philmcm/tbc/3dmodels/LQM21DH100M70L.STEP

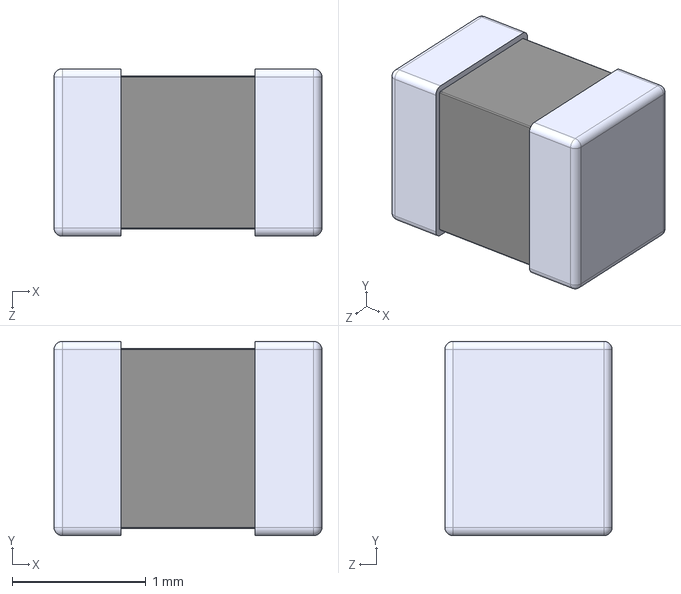
[picture p1: CAD file, 2024-02-20]
3dmodels/LQM21DH100M70L.STEP
2.00 x 1.45 x 1.25 mm
