philmcm/tbc/3dmodels/GRM32ER71E226KE15L.STEP

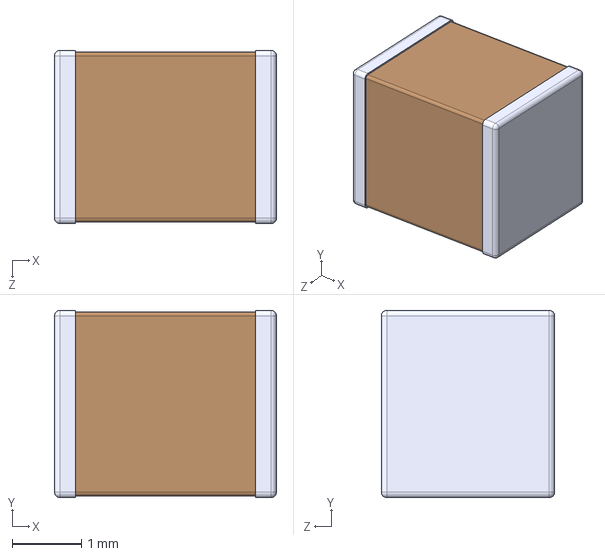
[picture p2: CAD file, 2024-02-19]
3dmodels/GRM32ER71E226KE15L.STEP
3.20 x 2.70 x 2.50 mm
