philmcm/tbc/3dmodels/ABLS.STEP

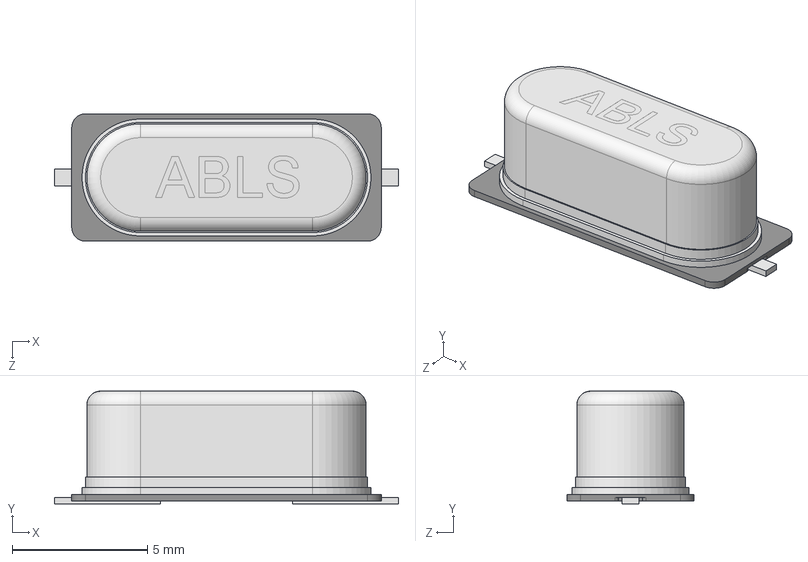
[picture p3: CAD file, 2024-02-18]
3dmodels/ABLS.STEP
12.7 x 4.17 x 4.70 mm
