philmcm/tbc/3dmodels/ABLS2.STEP

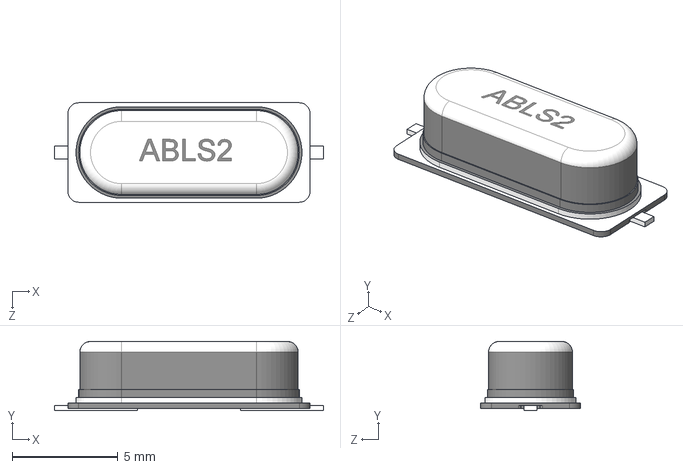
[picture p4: CAD file, 2024-02-18]
3dmodels/ABLS2.STEP
12.7 x 3.27 x 4.70 mm
