philmcm/tbc/3dmodels/D0014A.stp

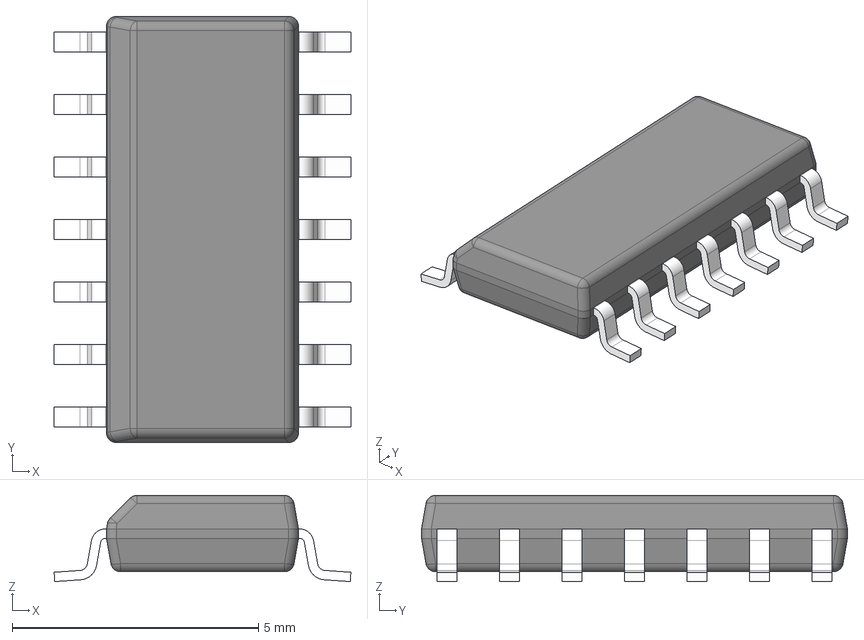
[picture p5: CAD file, 2024-02-14]
3dmodels/D0014A.stp
6.03 x 8.65 x 1.75 mm
BODY-SO
LEAD-SO x 14
PIN1-ID
