philmcm/tbc/3dmodels/ACHL.STEP

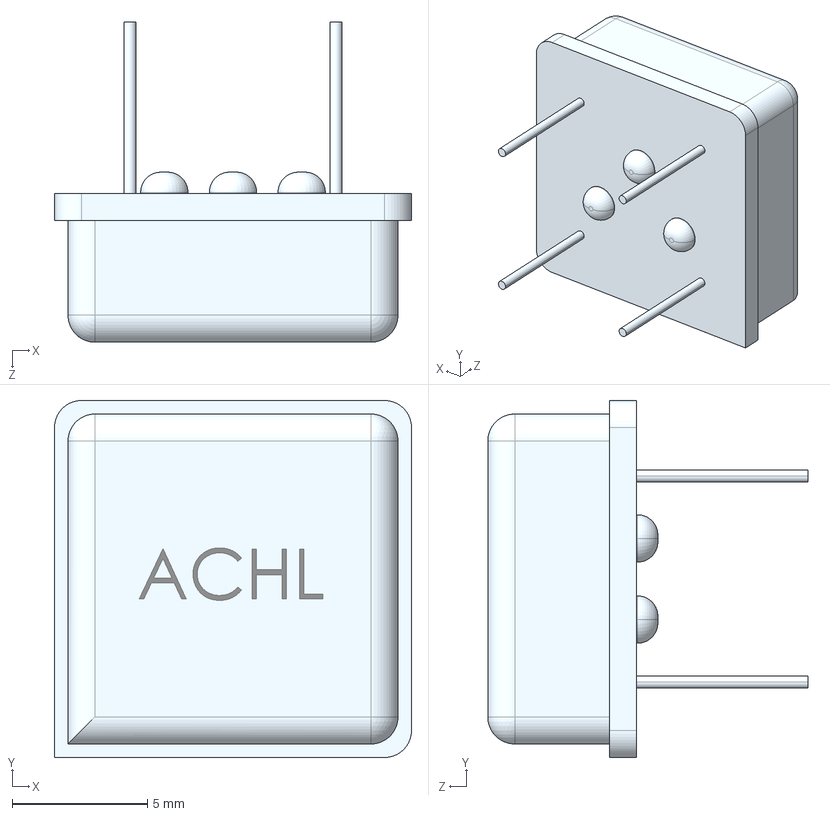
[picture p6: CAD file, 2024-02-12]
3dmodels/ACHL.STEP
13.2 x 13.2 x 11.9 mm
