philmcm/tbc/3dmodels/FSM4JLH(1825910-5).step

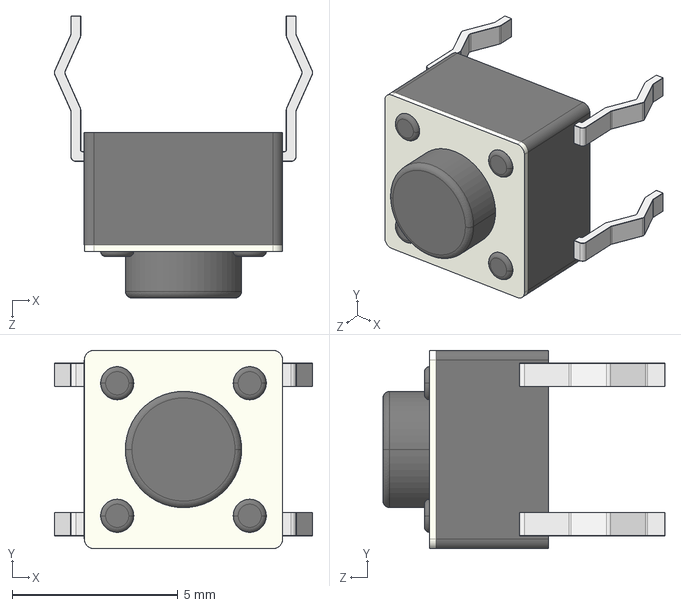
[picture p8: CAD file, 2024-02-12]
3dmodels/FSM4JLH(1825910-5).step
7.80 x 5.99 x 8.51 mm
