philmcm/tbc/3dmodels/KTT0003B.stp

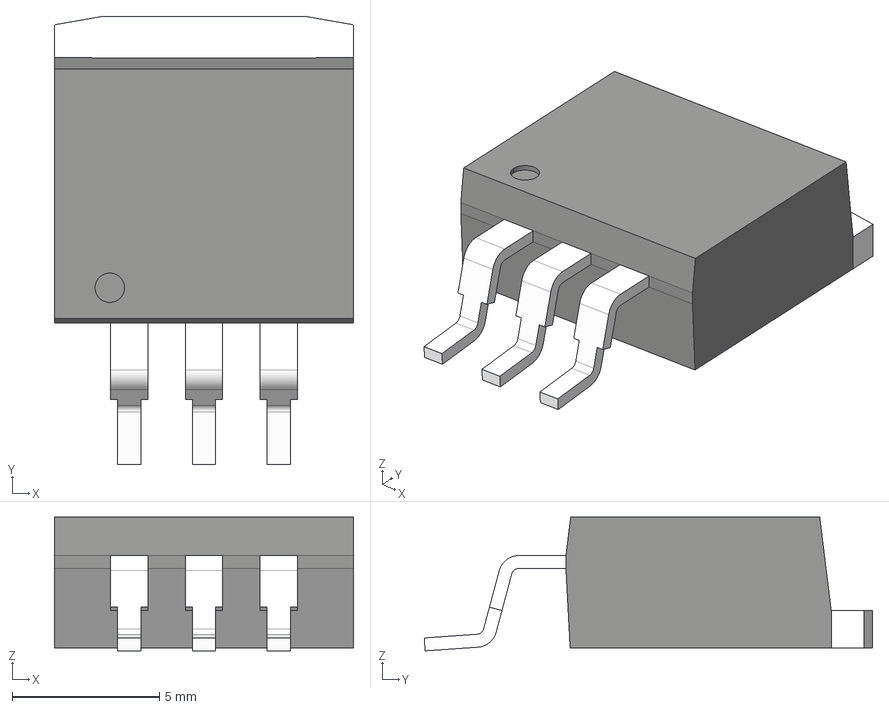
[picture p9: CAD file, 2024-02-11]
3dmodels/KTT0003B.stp
10.2 x 15.2 x 4.54 mm
BODY-TO
HTSINK-TO263
LEAD-TO263 x 3
