philmcm/tbc/3dmodels/C-CASE.stp

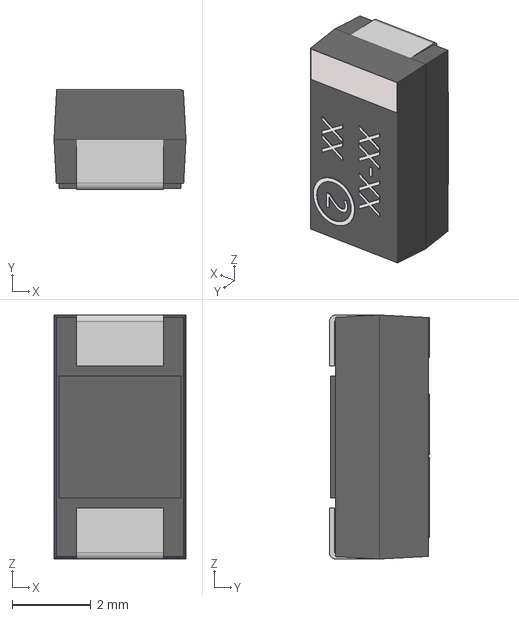
[picture p10: CAD file, 2024-02-11]
3dmodels/C-CASE.stp
3.35 x 2.54 x 6.20 mm
