philmcm/tbc/3dmodels/D-CASE.stp

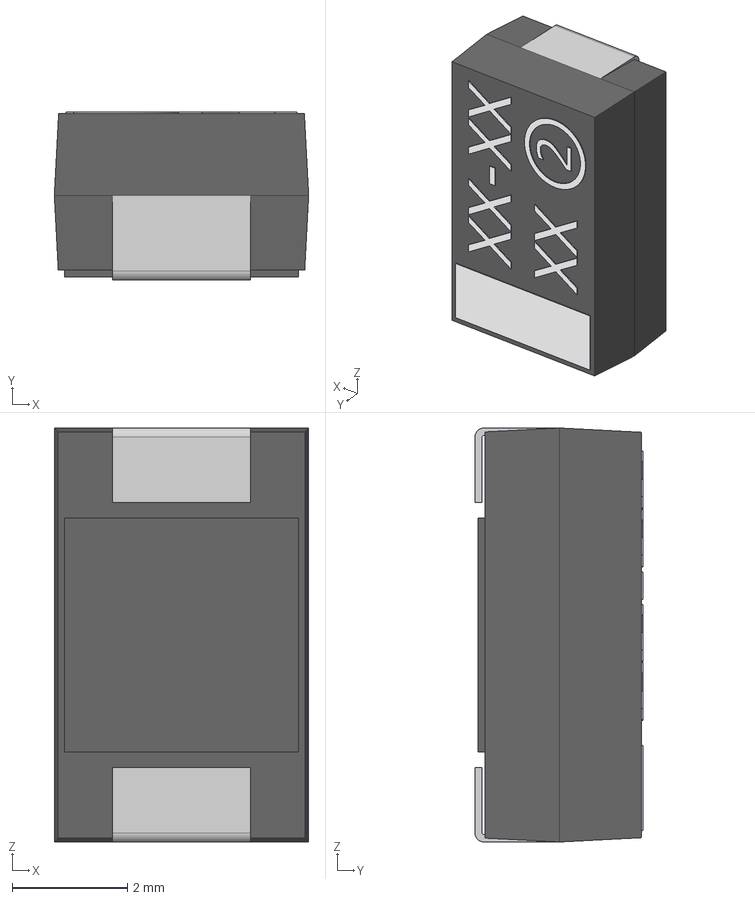
[picture p11: CAD file, 2024-02-11]
3dmodels/D-CASE.stp
4.42 x 2.92 x 7.19 mm
