philmcm/tbc/3dmodels/CircuitWorks-SOT-23.step

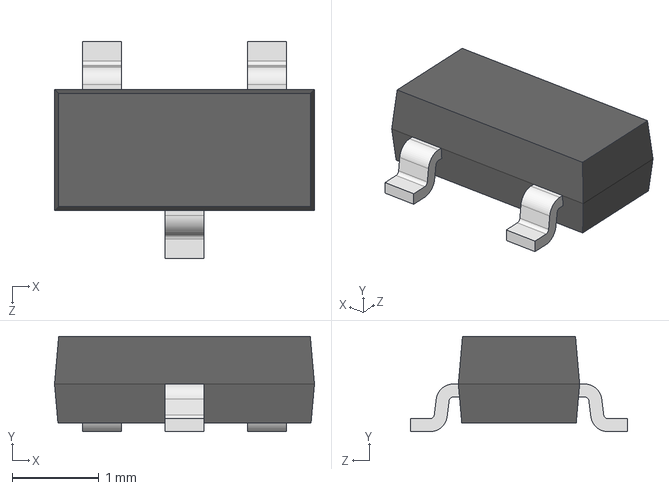
[picture p12: CAD file, 2024-02-11]
3dmodels/CircuitWorks-SOT-23.step
3.00 x 1.10 x 2.50 mm
