philmcm/tbc/3dmodels/PJRAN3X1U03X--3DModel-STEP-56544.STEP

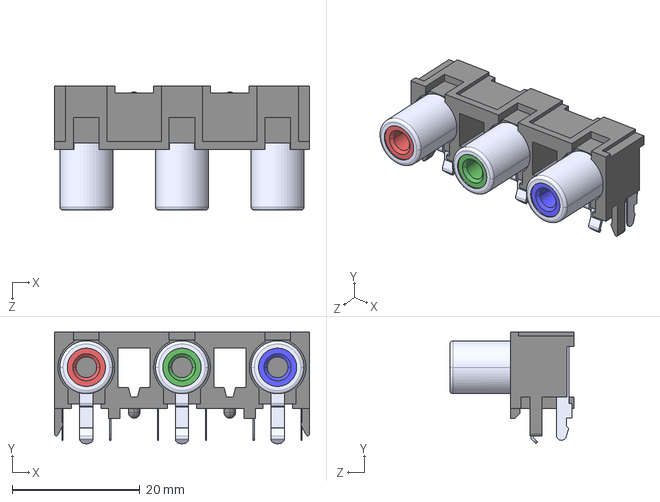
[picture p13: CAD file, 2024-02-11]
3dmodels/PJRAN3X1U03X--3DModel-STEP-56544.STEP
40.0 x 17.5 x 19.5 mm
