philmcm/tbc/3dmodels/A11AH-GA.stp

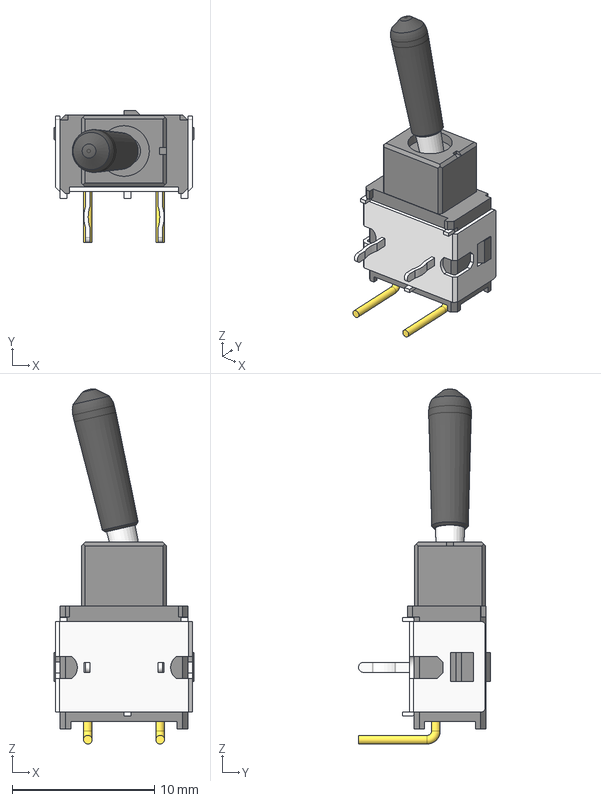
[picture p14: CAD file, 2024-02-11]
3dmodels/A11AH-GA.stp
9.80 x 9.27 x 24.9 mm
A1-toggle-body
A11H-toggle-terminals
A1H-toggle-bracket_ra
AA-toggle-toggle
AA-GA-toggle-cap
