philmcm/tbc/3dmodels/c-5749181-1-a-3d.stp

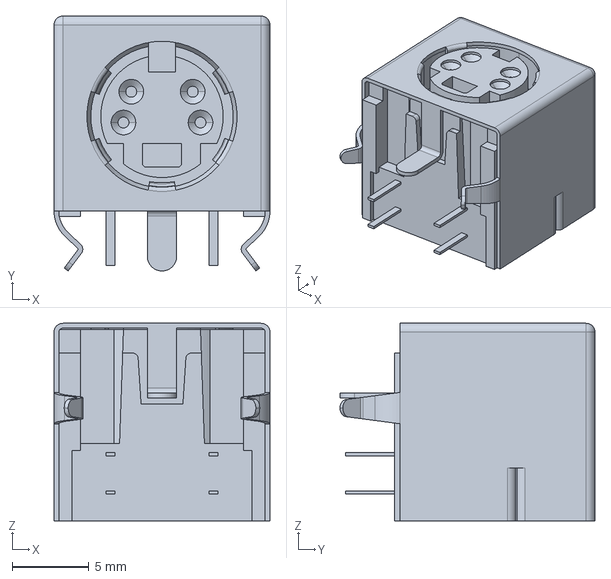
[picture p15: CAD file, 2024-02-11]
3dmodels/c-5749181-1-a-3d.stp
14.0 x 16.6 x 12.8 mm
