philmcm/tbc/3dmodels/4840.2201-04.STEP

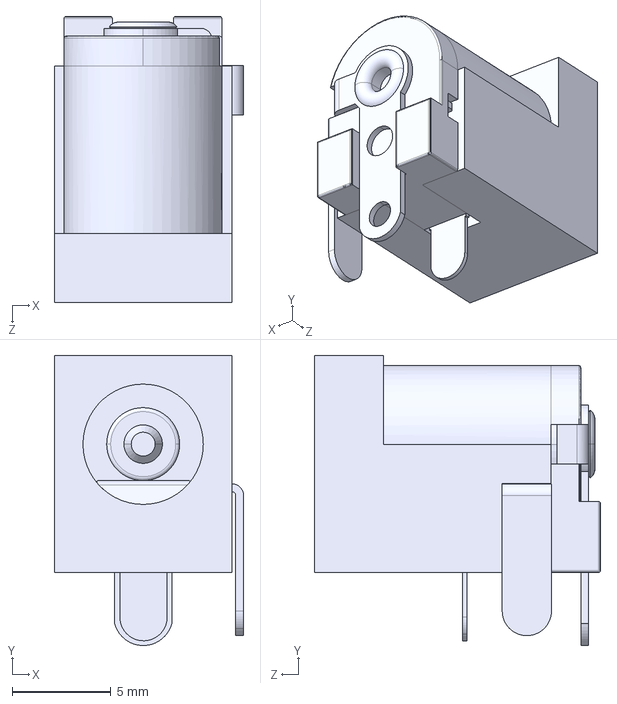
[picture p16: CAD file, 2024-02-11]
3dmodels/4840.2201-04.STEP
9.59 x 14.7 x 14.5 mm
