philmcm/tbc/3dmodels/pjran1x1_Series.STEP

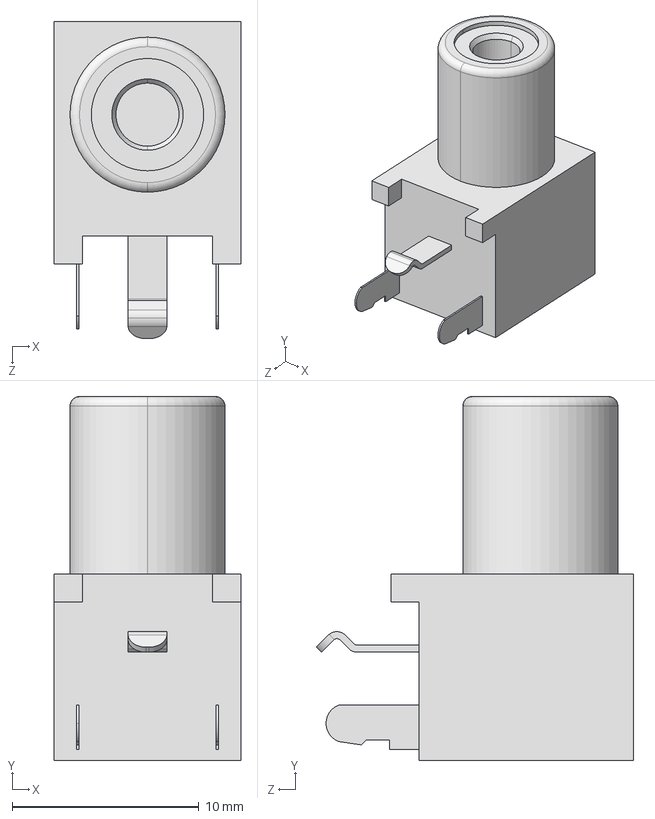
[picture p17: CAD file, 2024-02-11]
3dmodels/pjran1x1_Series.STEP
10.00 x 19.5 x 17.0 mm
