philmcm/tbc/3dmodels/R0603.step

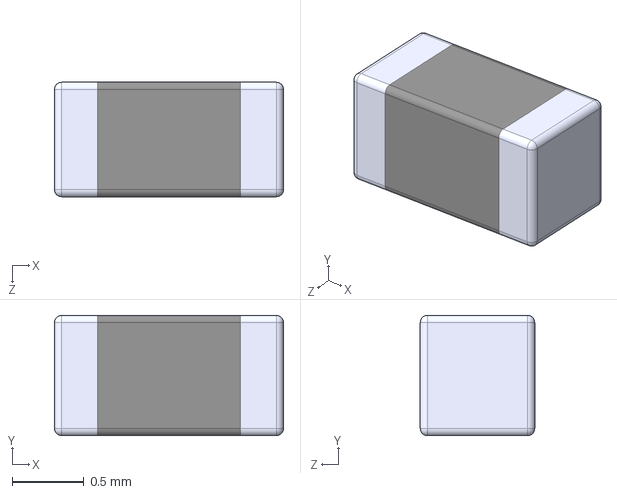
[picture p18: CAD file, 2024-02-10]
3dmodels/R0603.step
1.60 x 0.84 x 0.8 mm
