philmcm/tbc/3dmodels/QFP80_080.step

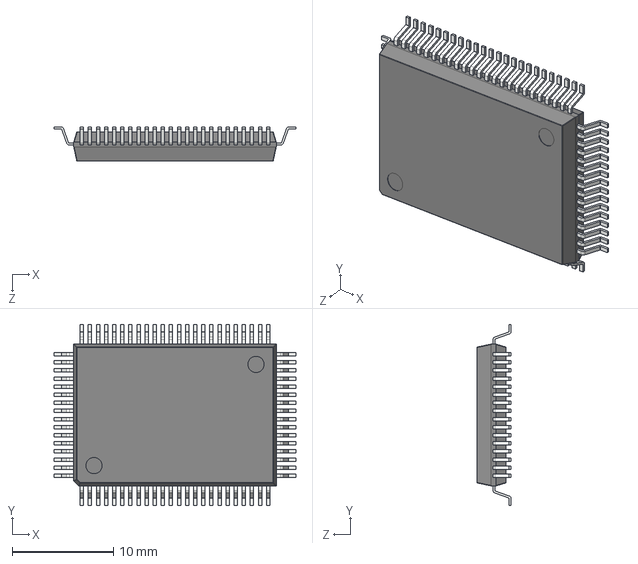
[picture p19: CAD file, 2024-02-10]
3dmodels/QFP80_080.step
23.9 x 17.9 x 3.40 mm
