philmcm/tbc/3dmodels/LQFP32.STEP

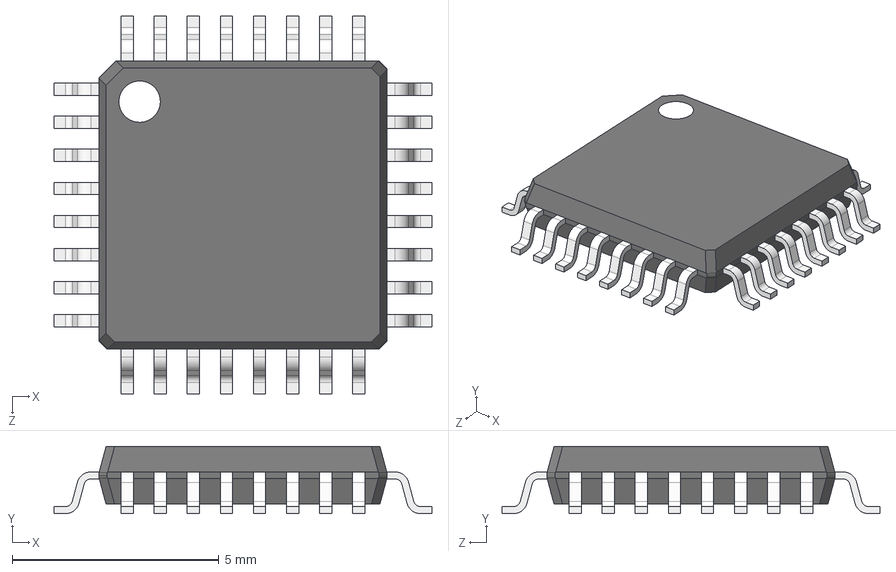
[picture p20: CAD file, 2024-02-10]
3dmodels/LQFP32.STEP
9.14 x 1.63 x 9.14 mm
case
pin x 32
circle
