philmcm/tbc/3dmodels/TSOP-44_II.step

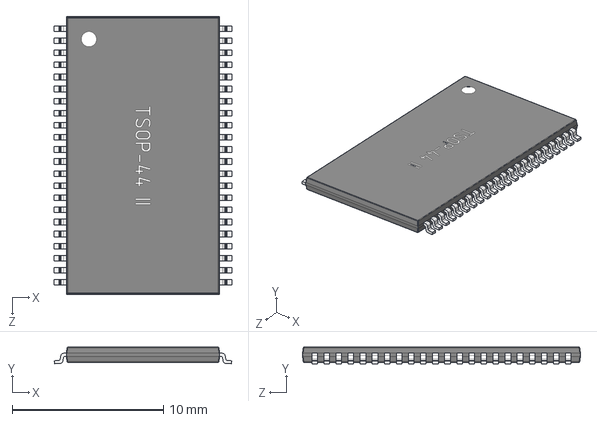
[picture p21: CAD file, 2024-02-10]
3dmodels/TSOP-44_II.step
11.8 x 1.10 x 18.4 mm
