philmcm/tbc/3dmodels/LQFP100_05.step

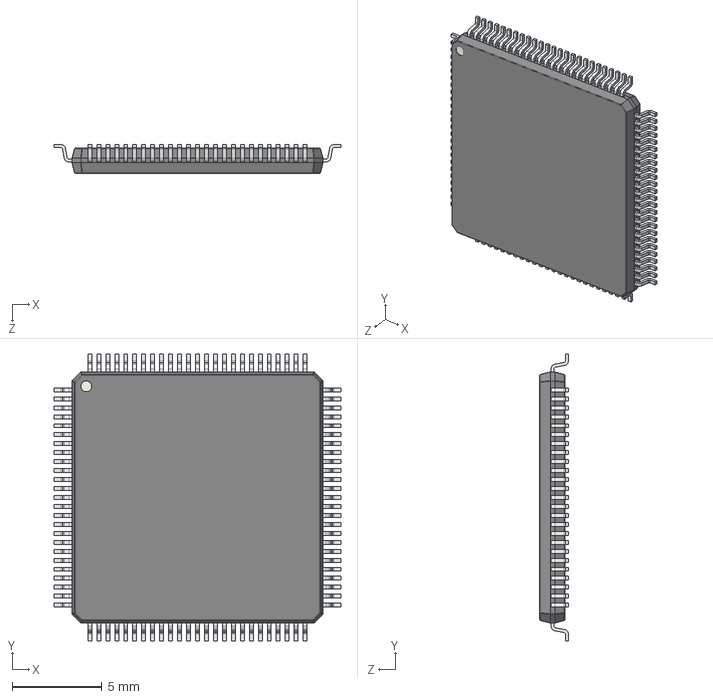
[picture p22: CAD file, 2024-01-27]
3dmodels/LQFP100_05.step
16.0 x 16.0 x 1.60 mm
