philmcm/tbc/(list of files, cad)

Other CAD files:
3dmodels/20021111-00010T4LF.STEP
3dmodels/75869-105LF--3DModel-STEP-56544.STEP
3dmodels/DFE201610E-100M%3DP2.STEP
