philmcm/tbc/plots/tbc__Assembly.pdf

1 | 2 | 3 | 4 | 5 | 6

A

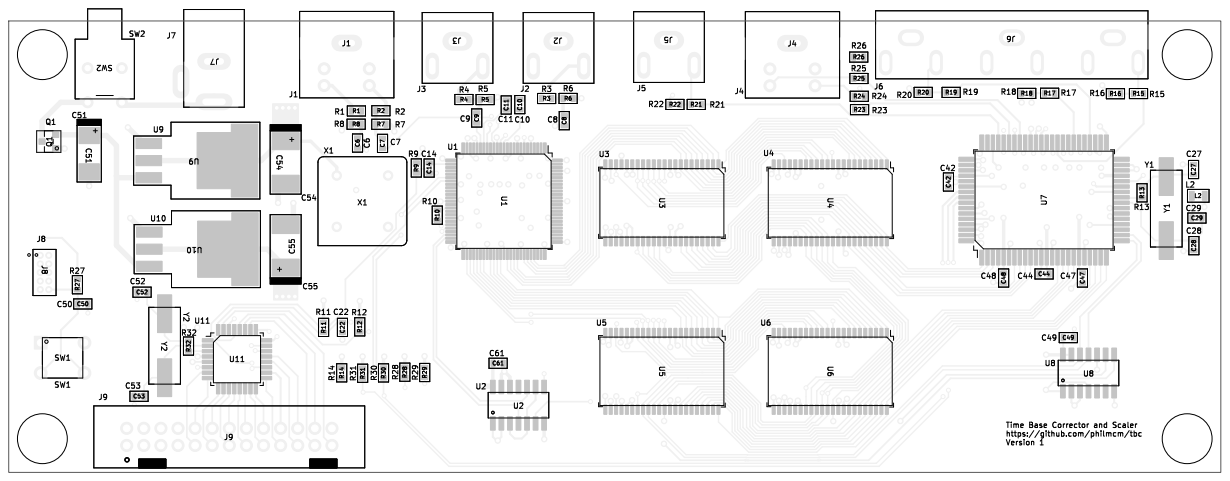
[picture p23: page 1]

Id: 1/1 Title: File: tbc.kicad_pcb Sheet: C⁹ + C⁵⁵

1 | 2 | 3 | 4 | 5 | 6

A

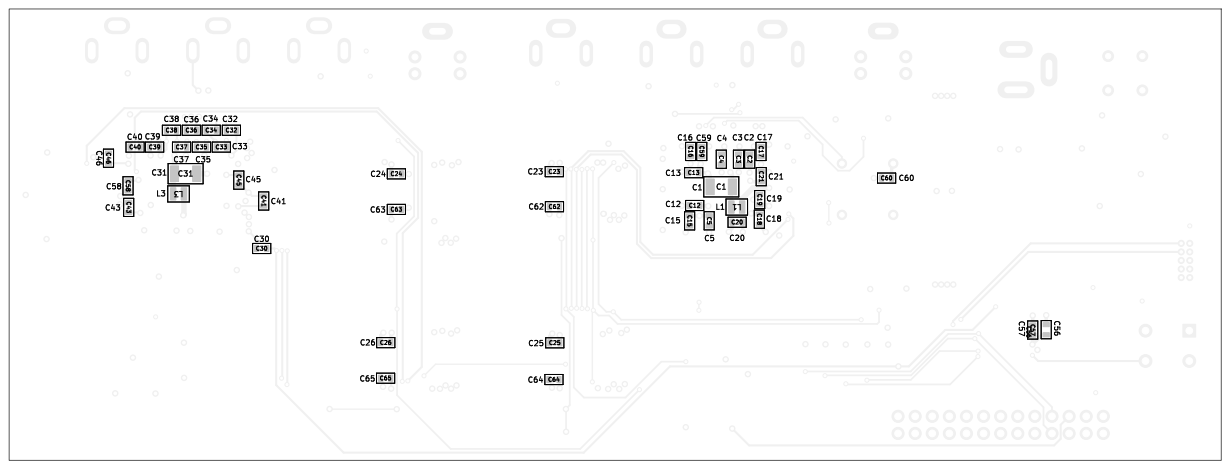
[picture p24: page 2]

Id: 1/1 Title: File: tbc.kicad_pcb Sheet:
