philmcm/tbc/tbc.pdf

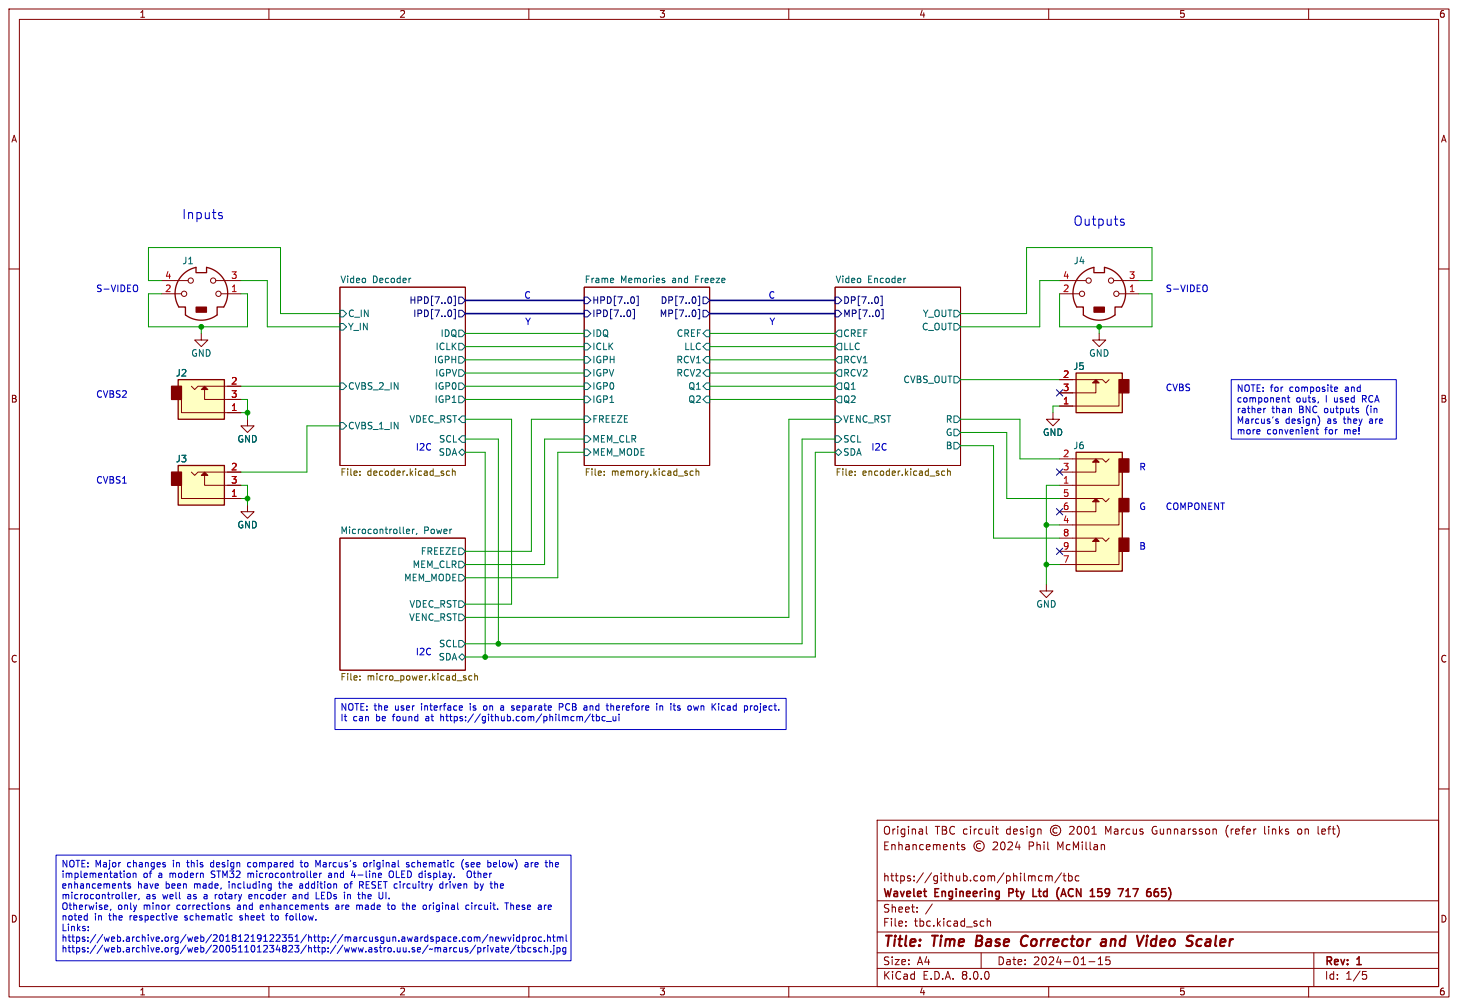
[picture p25: page 1]

C_OUT CVBS_OUT Y_OUT VENC_RST Q2 Q1 Video Encoder File: encoder.kicad_sch SDA

https://web.archive.org/web/20051101234823/http://www.astro.uu.se/~marcus/private/tbcsch.jpg

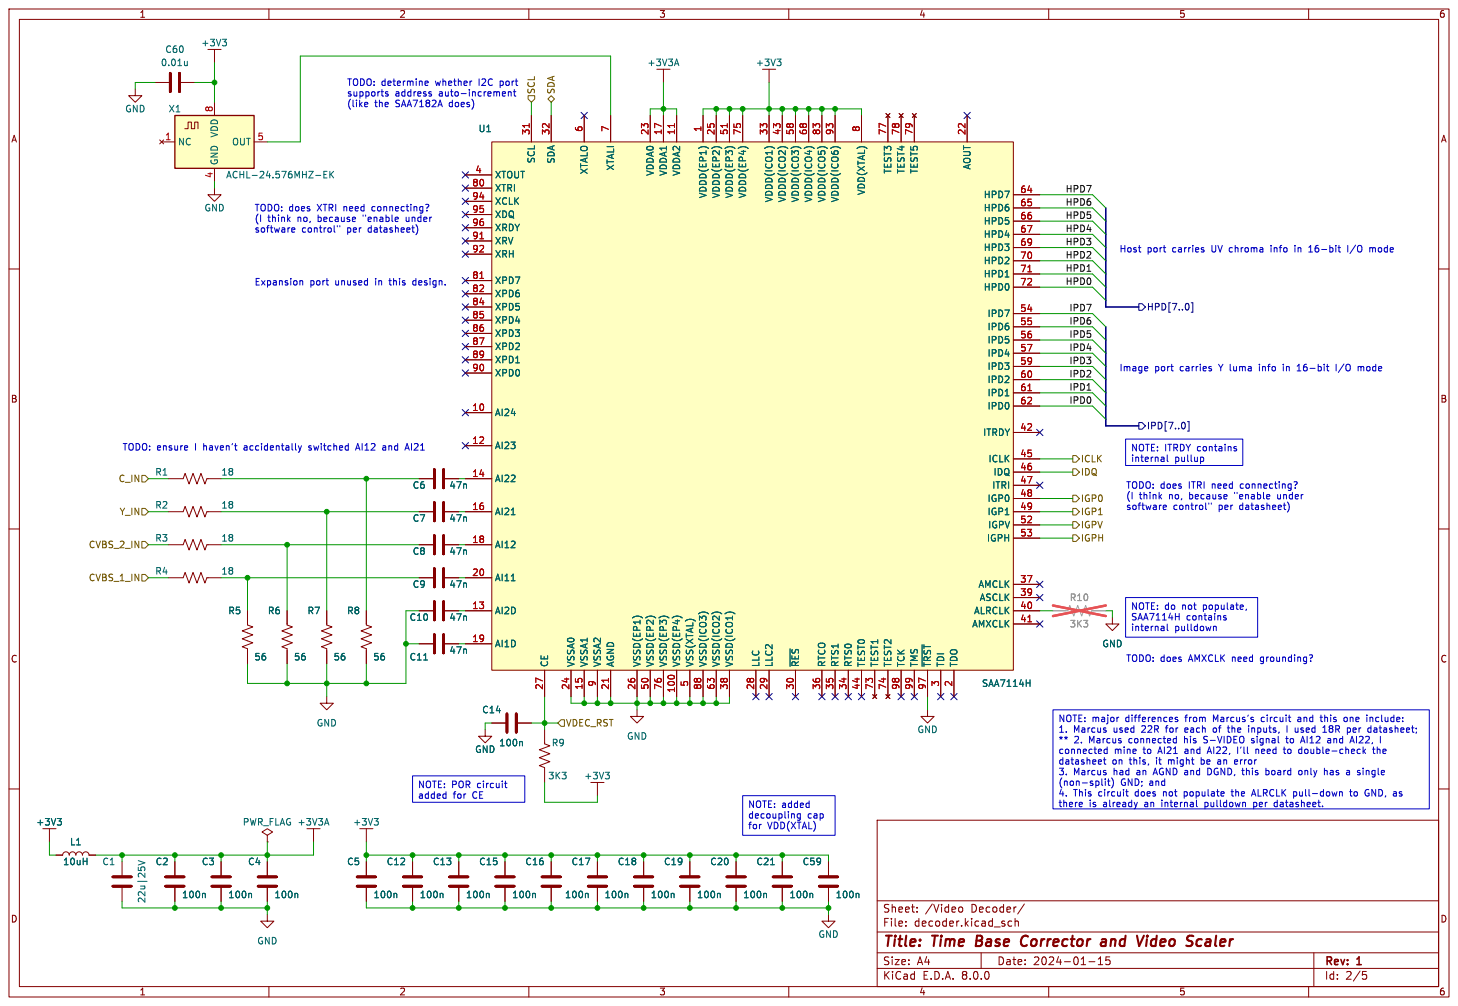
[picture p26: page 2]

4 OUT VDD 5 X1 8 ACHL-24.576MHZ-EK GND

9 XPD0 90 XRV 91 XRH 92 VDDD(ICO6) 93 XCLK 94 XDQ 95 XRDY 96 ~{TRST} 97 TCK 98 TMS 99 U1 SAA7114H

9 XPD0 90 XRV 91 XRH 92 VDDD(ICO6) 93 XCLK 94 XDQ 95 XRDY 96 ~{TRST} 97 TCK 98 TMS 99 GND

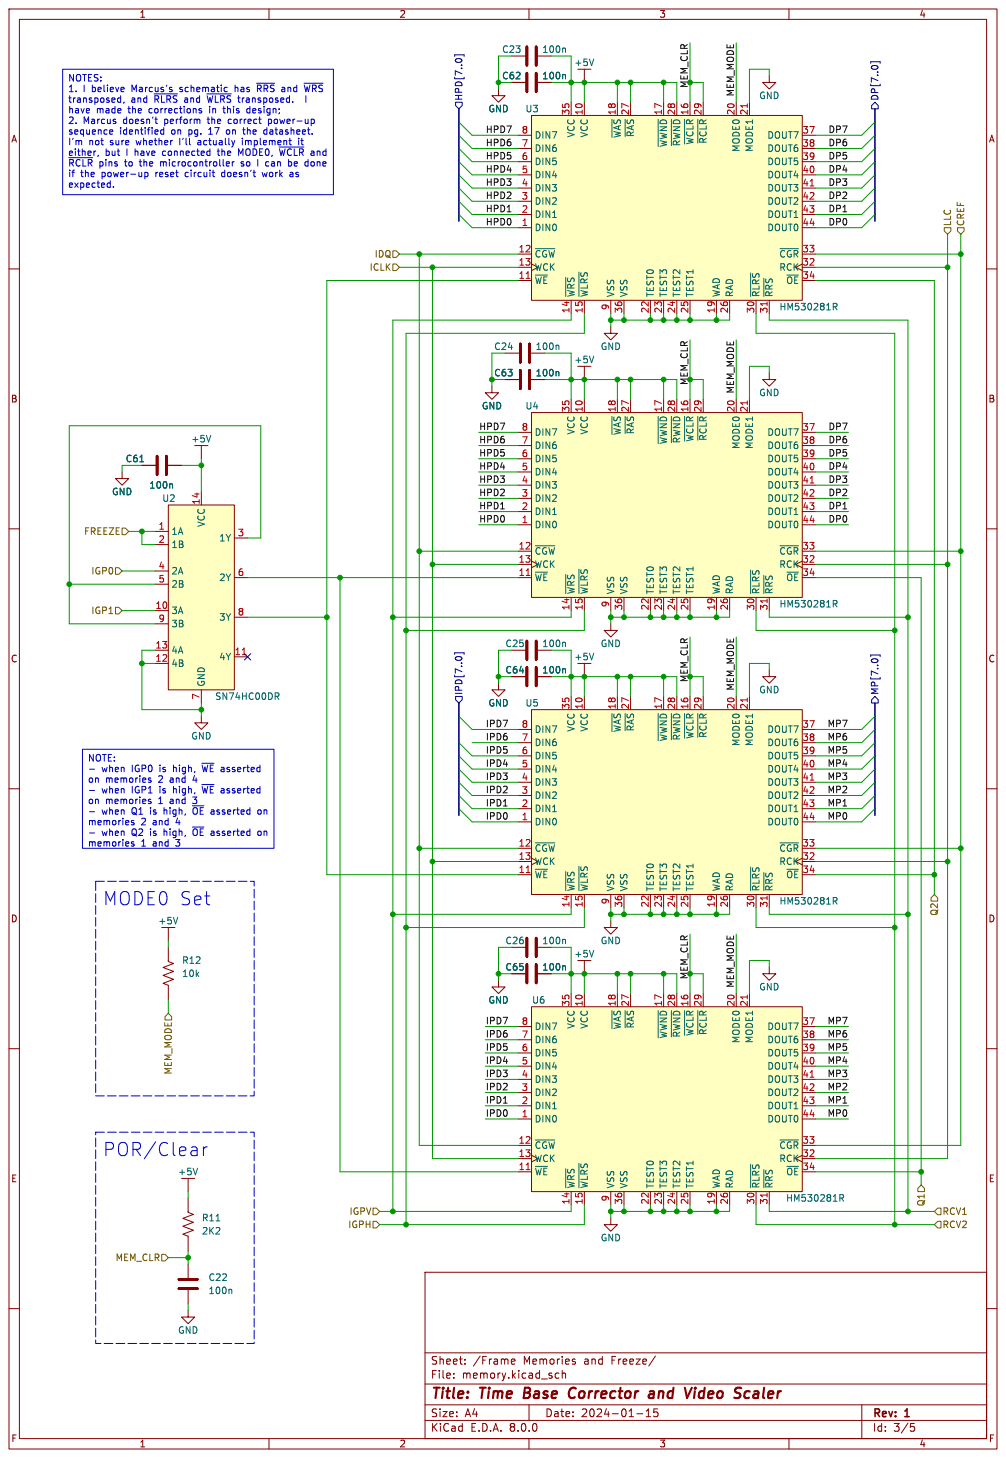
[picture p27: page 3]

POR/Clear NOTE: - when IGP0 is high, ~{WE}asserted

9 WCK 13 RCK 32 U5 HM530281R GND GND GND

- when IGP1 is high, ~{WE}asserted

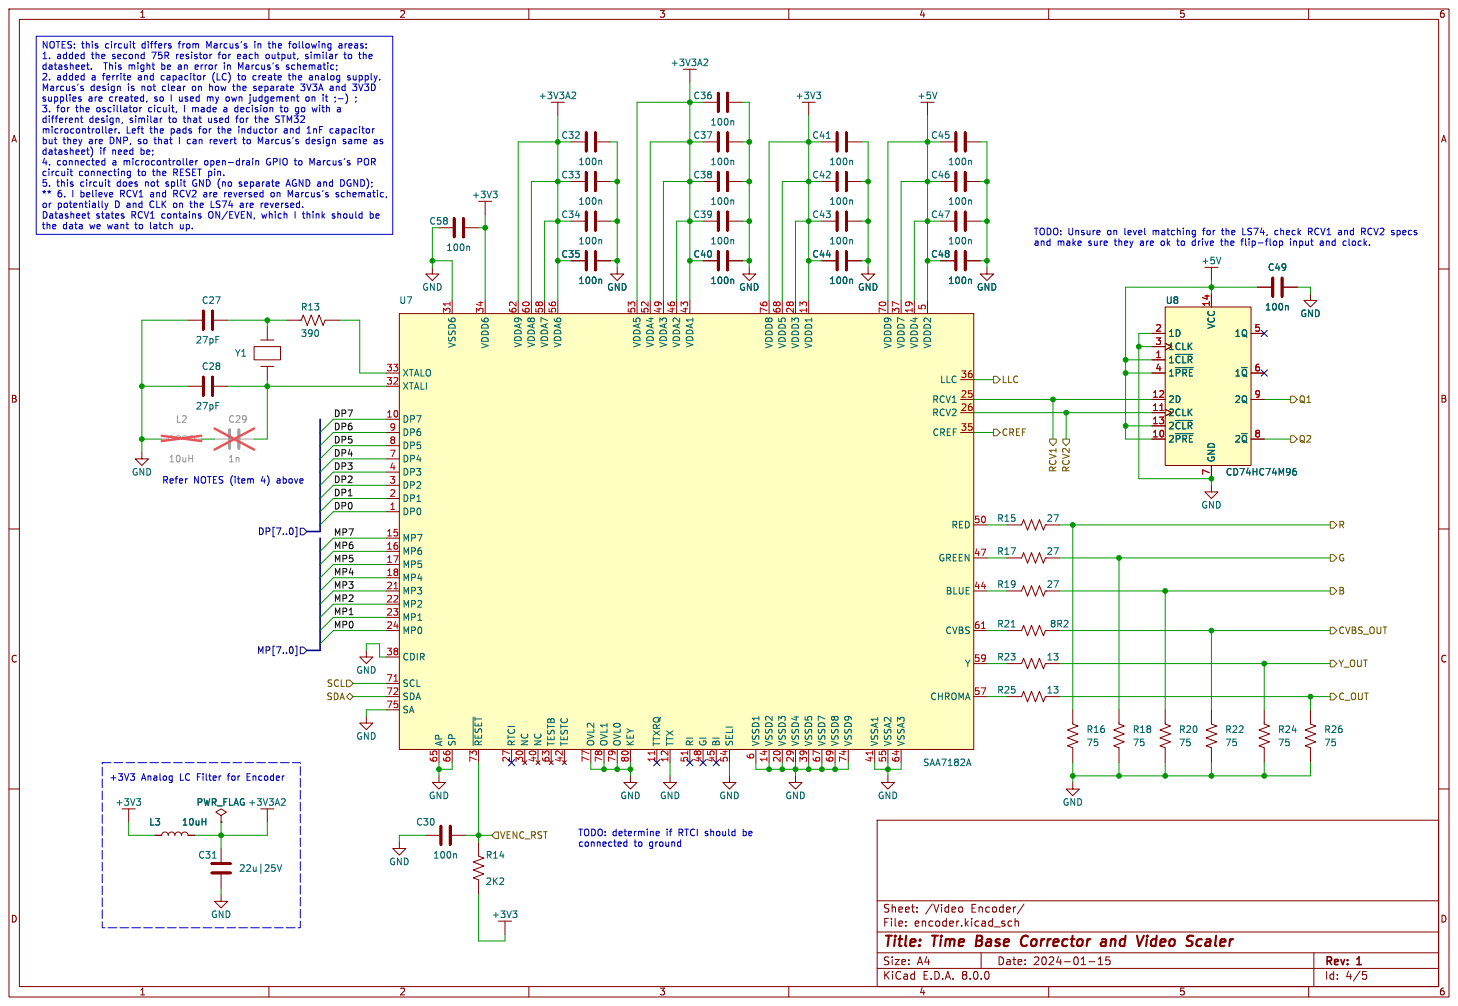
[picture p28: page 4]

6 VDDA8 60 CVBS 61 VDDA9 62 TESTB 63 VSSA3 64 AP 65 SP 66 VSSD7 67 VDDD5 68 VSSD8 69 DP4 7 VDDD9 70

5 RED 50 RI 51 VDDA4 52 VDDA5 53 SELI 54 VSSA2 55 VDDA6 56 CHROMA 57 VDDA7 58 Y

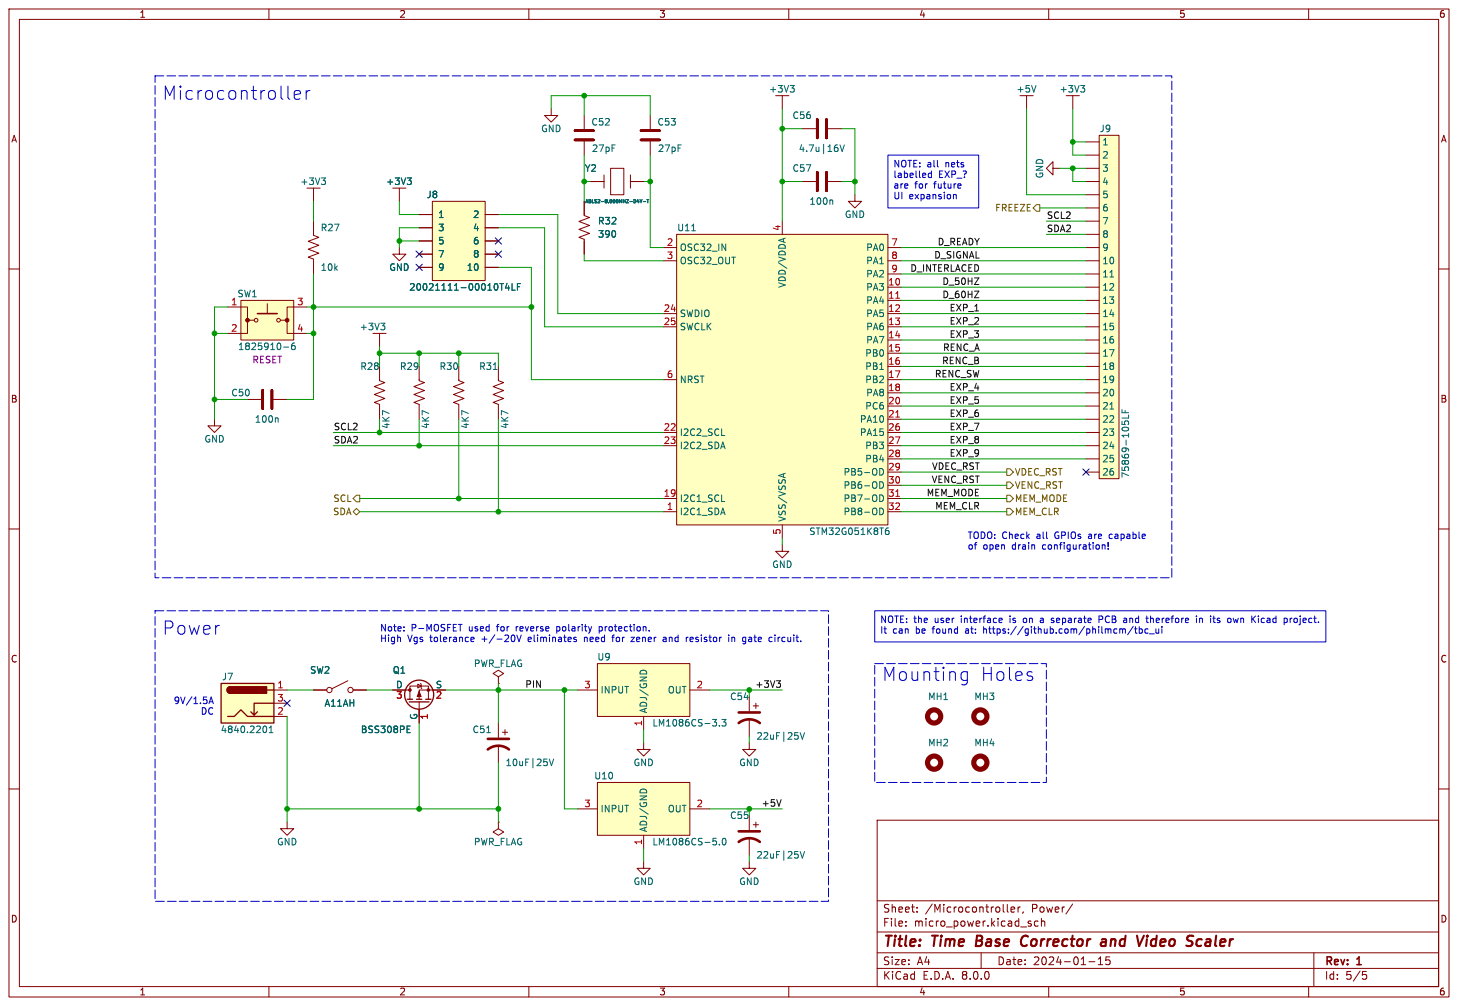
[picture p29: page 5]

TODO: Check all GPIOs are capable
of open drain configuration!
