philmcm/tbc/tbc.kicad_pcb

## KiCad design tbc.kicad_pcb (2025-01-18)

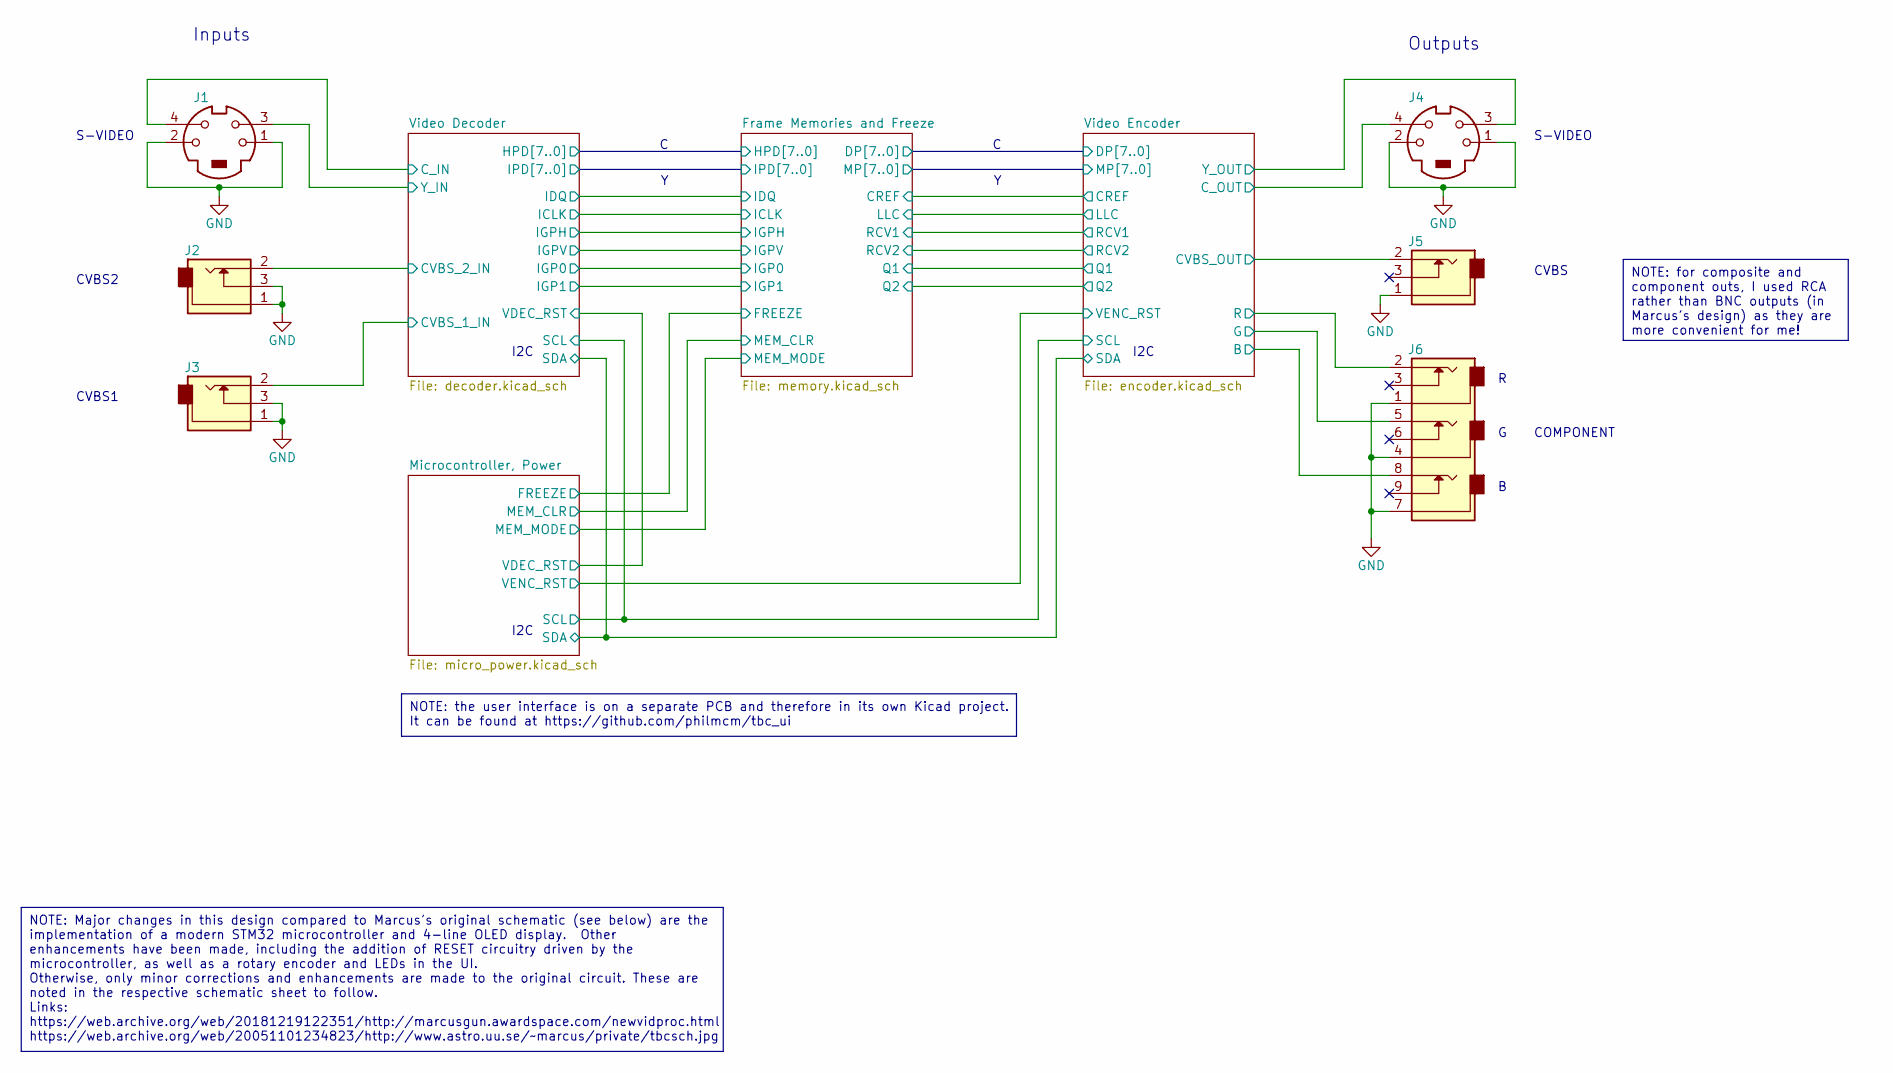
[picture p30: schematic tbc.kicad_sch, Time Base Corrector and Video Scaler]

Parts:
J1, J4: 5749181-1; Mouser 571-5749181-1
J2, J3, J5: PJRAN1X1U01X; Mouser 502-PJRAN1X1U01X
J6: PJRAN3X1U03X; Mouser 502-PJRAN3X1U03X

Connections:
/Video Decoder/CVBS_1_IN: J3.2; also elsewhere on the board
/Video Decoder/CVBS_2_IN: J2.2; also elsewhere on the board
/Video Decoder/C_IN: J1.4; also elsewhere on the board
/Video Decoder/Y_IN: J1.3; also elsewhere on the board
/Video Encoder/B: J6.8; also elsewhere on the board
/Video Encoder/CVBS_OUT: J5.2; also elsewhere on the board
/Video Encoder/C_OUT: J4.4; also elsewhere on the board
/Video Encoder/G: J6.5; also elsewhere on the board
/Video Encoder/R: J6.2; also elsewhere on the board
/Video Encoder/Y_OUT: J4.3; also elsewhere on the board
GND: J1.1, J1.2, J2.1, J2.3, J3.1, J3.3, J4.1, J4.2, J5.1, J6.1, J6.4, J6.7; also elsewhere on the board

Notes on the sheet:
NOTE: Major changes in this design compared to Marcus's original schematic (see below) are the implementation of a modern STM32 microcontroller and 4-line OLED display. Other enhancements have been made, including the addition of RESET circuitry driven by the microcontroller, as well as a rotary en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
NOTE: for composite and component outs, I used RCA rather than BNC outputs (in Marcus's design) as they are more convenient for me!
NOTE: the user interface is on a separate PCB and therefore in its own Kicad project. It can be found at https://github.com/philmcm/tbc_ui
Inputs
CVBS1
I2C
COMPONENT
CVBS
Outputs
CVBS2
S-VIDEO

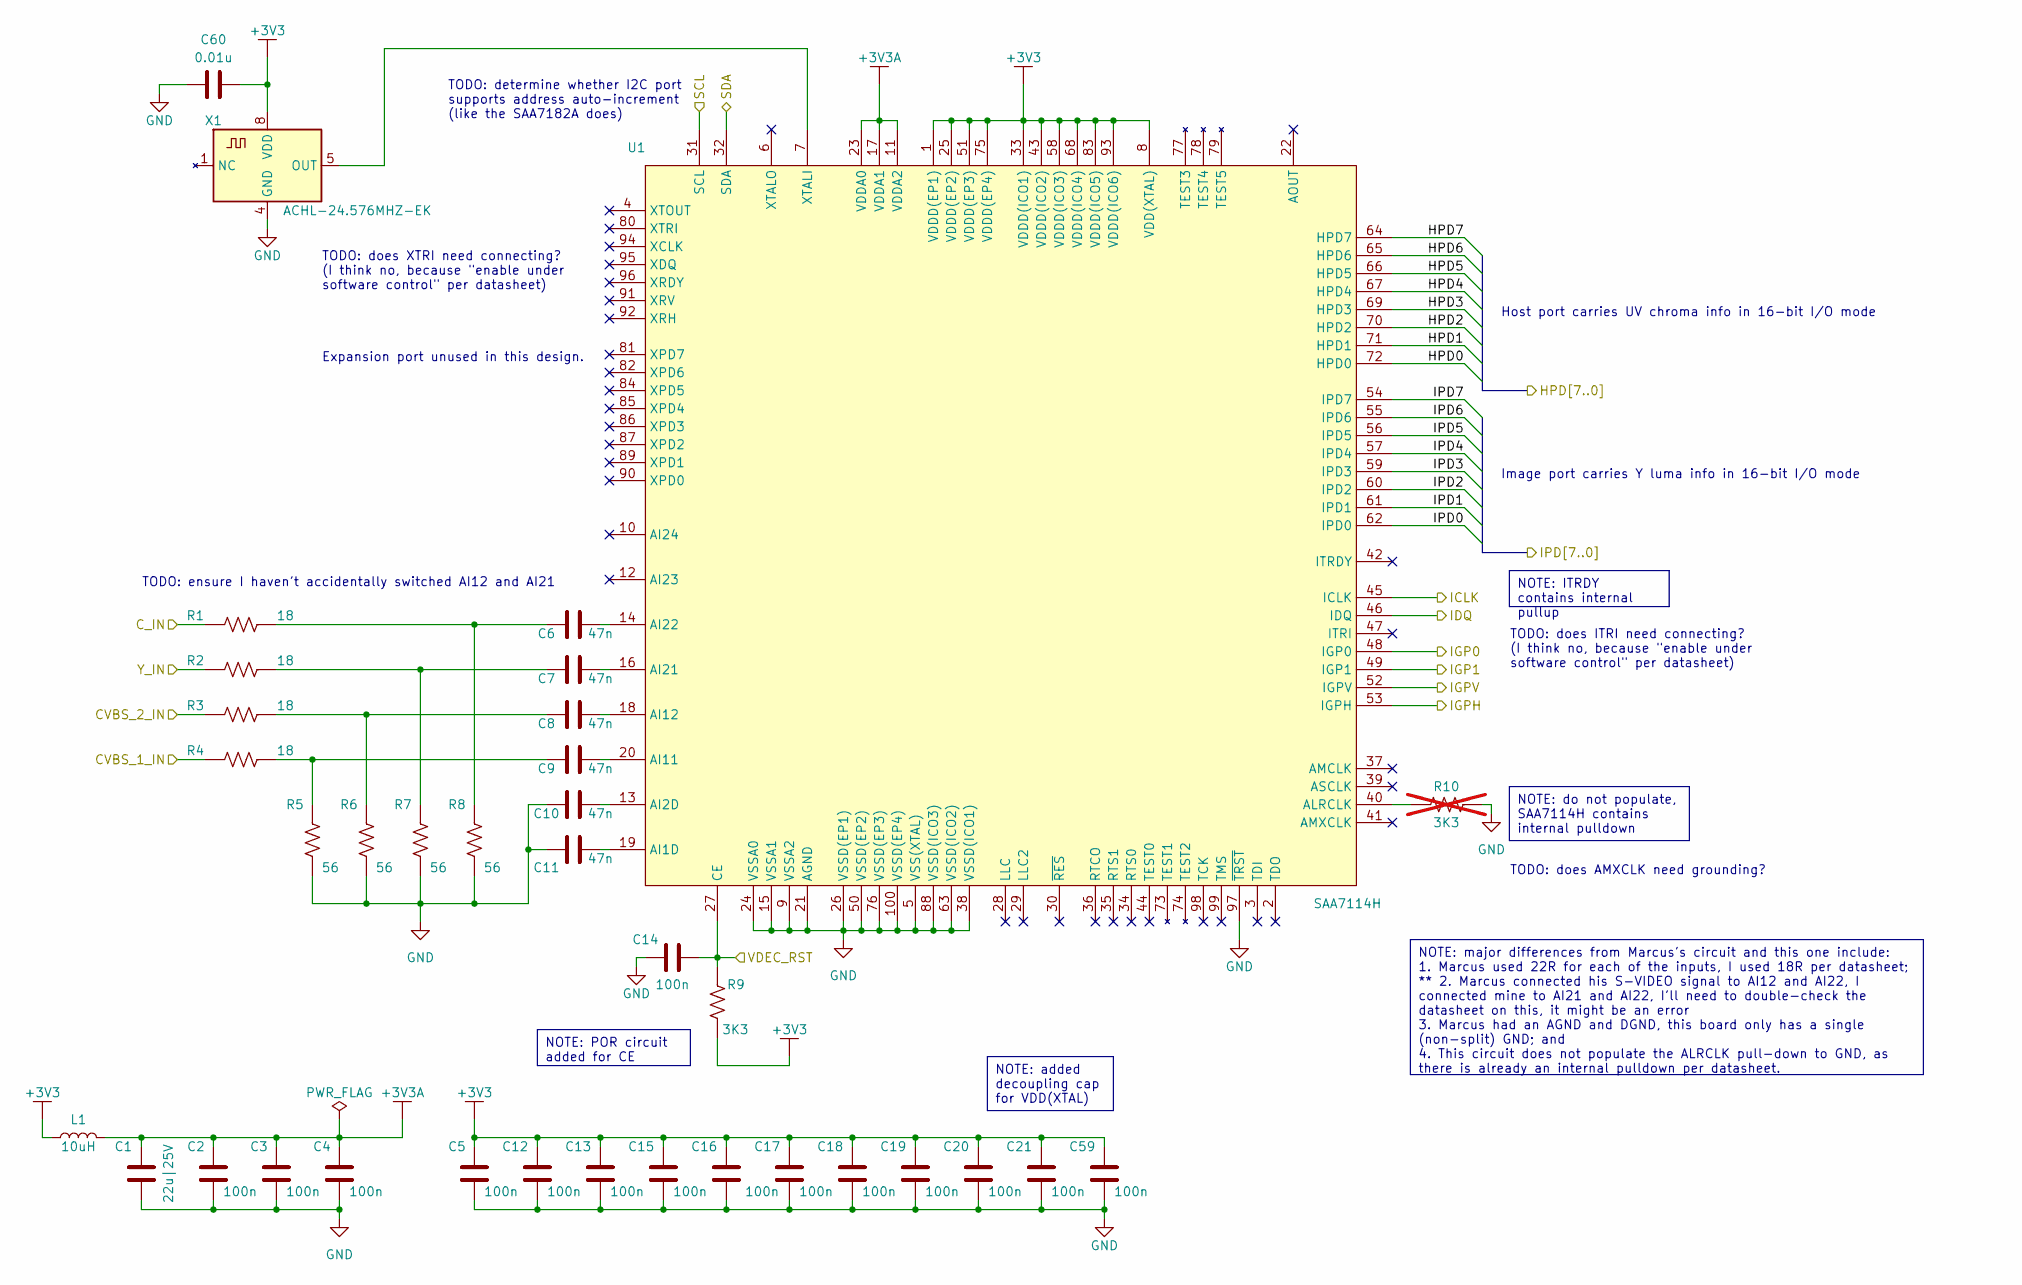
[picture p31: schematic decoder.kicad_sch, Time Base Corrector and Video Scaler]

Parts:
C1: 22u|25V; GRM32; Mouser 81-GRM32ER71E226KE5L
C2, C3, C4, C5, C12, C13, C14, C15, C16, C17, C18, C19, C20, C21, C59: 100n; C0603; Mouser 81-GCJ188R71H104KA2D
C6, C7, C8, C9, C10, C11: 47n; C0603; Mouser 81-GCJ188R71E473KA1D
C60: 0.01u; C0603; Mouser 81-GCM188R71H103KA7J
L1: 10uH; DFE201610E; Mouser 81-DFE201610E-100MP2
R1, R2, R3, R4: 18; R0603; Mouser 603-RC0603FR-0718RL
R5, R6, R7, R8: 56; R0603; Mouser 603-RC0603FR-0756RL
R9: 3K3; R0603; Mouser 603-RC0603FR-073K3L
R10: 3K3; R0603; Mouser 603-RC0603FR-073K3L; not fitted
U1: SAA7114H; LQFP100_14x14x1.4mm_Pitch0.5mm
X1: ACHL-24.576MHZ-EK; ACHL; Mouser 815-ACHL-24.576-EK

Connections:
+3V3: C5.2, C12.2, C13.2, C15.2, C16.2, C17.2, C18.2, C19.2, C20.2, C21.2, C59.2, C60.2, L1.1, R9.1, U1.1 (VDDD(EP1)), U1.8 (VDD(XTAL)), U1.25 (VDDD(EP2)), U1.33 (VDDD(ICO1)), U1.43 (VDDD(ICO2)), U1.51 (VDDD(EP3)), U1.58 (VDDD(ICO3)), U1.68 (VDDD(ICO4)), U1.75 (VDDD(EP4)), U1.83 (VDDD(ICO5)), U1.93 (VDDD(ICO6)), X1.8 (VDD); also elsewhere on the board
+3V3A: C1.2, C2.2, C3.2, C4.2, L1.2, U1.11 (VDDA2), U1.17 (VDDA1), U1.23 (VDDA0)
/Frame Memories and Freeze/HPD0: U1.72 (HPD0); also elsewhere on the board
/Frame Memories and Freeze/HPD1: U1.71 (HPD1); also elsewhere on the board
/Frame Memories and Freeze/HPD2: U1.70 (HPD2); also elsewhere on the board
/Frame Memories and Freeze/HPD3: U1.69 (HPD3); also elsewhere on the board
/Frame Memories and Freeze/HPD4: U1.67 (HPD4); also elsewhere on the board
/Frame Memories and Freeze/HPD5: U1.66 (HPD5); also elsewhere on the board
/Frame Memories and Freeze/HPD6: U1.65 (HPD6); also elsewhere on the board
/Frame Memories and Freeze/HPD7: U1.64 (HPD7); also elsewhere on the board
/Frame Memories and Freeze/ICLK: U1.45 (ICLK); also elsewhere on the board
/Frame Memories and Freeze/IDQ: U1.46 (IDQ); also elsewhere on the board
/Frame Memories and Freeze/IGP0: U1.48 (IGP0); also elsewhere on the board
/Frame Memories and Freeze/IGP1: U1.49 (IGP1); also elsewhere on the board
/Frame Memories and Freeze/IGPH: U1.53 (IGPH); also elsewhere on the board
/Frame Memories and Freeze/IGPV: U1.52 (IGPV); also elsewhere on the board
/Frame Memories and Freeze/IPD0: U1.62 (IPD0); also elsewhere on the board
/Frame Memories and Freeze/IPD1: U1.61 (IPD1); also elsewhere on the board
/Frame Memories and Freeze/IPD2: U1.60 (IPD2); also elsewhere on the board
/Frame Memories and Freeze/IPD3: U1.59 (IPD3); also elsewhere on the board
/Frame Memories and Freeze/IPD4: U1.57 (IPD4); also elsewhere on the board
/Frame Memories and Freeze/IPD5: U1.56 (IPD5); also elsewhere on the board
/Frame Memories and Freeze/IPD6: U1.55 (IPD6); also elsewhere on the board
/Frame Memories and Freeze/IPD7: U1.54 (IPD7); also elsewhere on the board
/Microcontroller, Power/SCL: U1.31 (SCL); also elsewhere on the board
/Microcontroller, Power/SDA: U1.32 (SDA); also elsewhere on the board
/Microcontroller, Power/VDEC_RST: C14.2, R9.2, U1.27 (CE); also elsewhere on the board
/Video Decoder/CVBS_1_IN: R4.1; also elsewhere on the board
/Video Decoder/CVBS_2_IN: R3.1; also elsewhere on the board
/Video Decoder/C_IN: R1.1; also elsewhere on the board
/Video Decoder/Y_IN: R2.1; also elsewhere on the board
GND: C1.1, C2.1, C3.1, C4.1, C5.1, C10.1, C11.1, C12.1, C13.1, C14.1, C15.1, C16.1, C17.1, C18.1, C19.1, C20.1, C21.1, C59.1, C60.1, R5.1, R6.1, R7.1, R8.1, R10.2, U1.5 (VSS(XTAL)), U1.9 (VSSA2), U1.15 (VSSA1), U1.21 (AGND), U1.24 (VSSA0), U1.26 (VSSD(EP1)), U1.38 (VSSD(ICO1)), U1.50 (VSSD(EP2)), U1.63 (VSSD(ICO2)), U1.76 (VSSD(EP3)), U1.88 (VSSD(ICO3)), U1.97 (~TRST), U1.100 (VSSD(EP4)), X1.4 (GND); also elsewhere on the board
unnamed: C6.1, R1.2, R8.2
unnamed: C7.1, R2.2, R7.2
unnamed: C8.1, R3.2, R6.2
unnamed: C9.1, R4.2, R5.2
unnamed: C11.2, U1.19 (AI1D)
unnamed: C10.2, U1.13 (AI2D)
unnamed: C9.2, U1.20 (AI11)
unnamed: C8.2, U1.18 (AI12)
unnamed: C7.2, U1.16 (AI21)
unnamed: C6.2, U1.14 (AI22)
unnamed: R10.1, U1.40 (ALRCLK)
unnamed: U1.7 (XTALI), X1.5 (OUT)

Notes on the sheet:
NOTE: ITRDY contains internal pullup
NOTE: do not populate, SAA7114H contains internal pulldown
NOTE: added decoupling cap for VDD(XTAL)
NOTE: POR circuit added for CE
NOTE: major differences from Marcus's circuit and this one include: 1. Marcus used 22R for each of the inputs, I used 18R per datasheet; ** 2. Marcus connected his S-VIDEO signal to AI12 and AI22, I connected mine to AI21 and AI22, I'll need to double-check the datasheet on this, it might be an err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
Image port carries Y luma info in 16-bit I/O mode
TODO: ensure I haven't accidentally switched AI12 and AI21
TODO: does AMXCLK need grounding?
Host port carries UV chroma info in 16-bit I/O mode
TODO: determine whether I2C port supports address auto-increment (like the SAA7182A does)
TODO: does ITRI need connecting? (I think no, because "enable under software control" per datasheet)
TODO: does XTRI need connecting? (I think no, because "enable under software control" per datasheet)
Expansion port unused in this design.

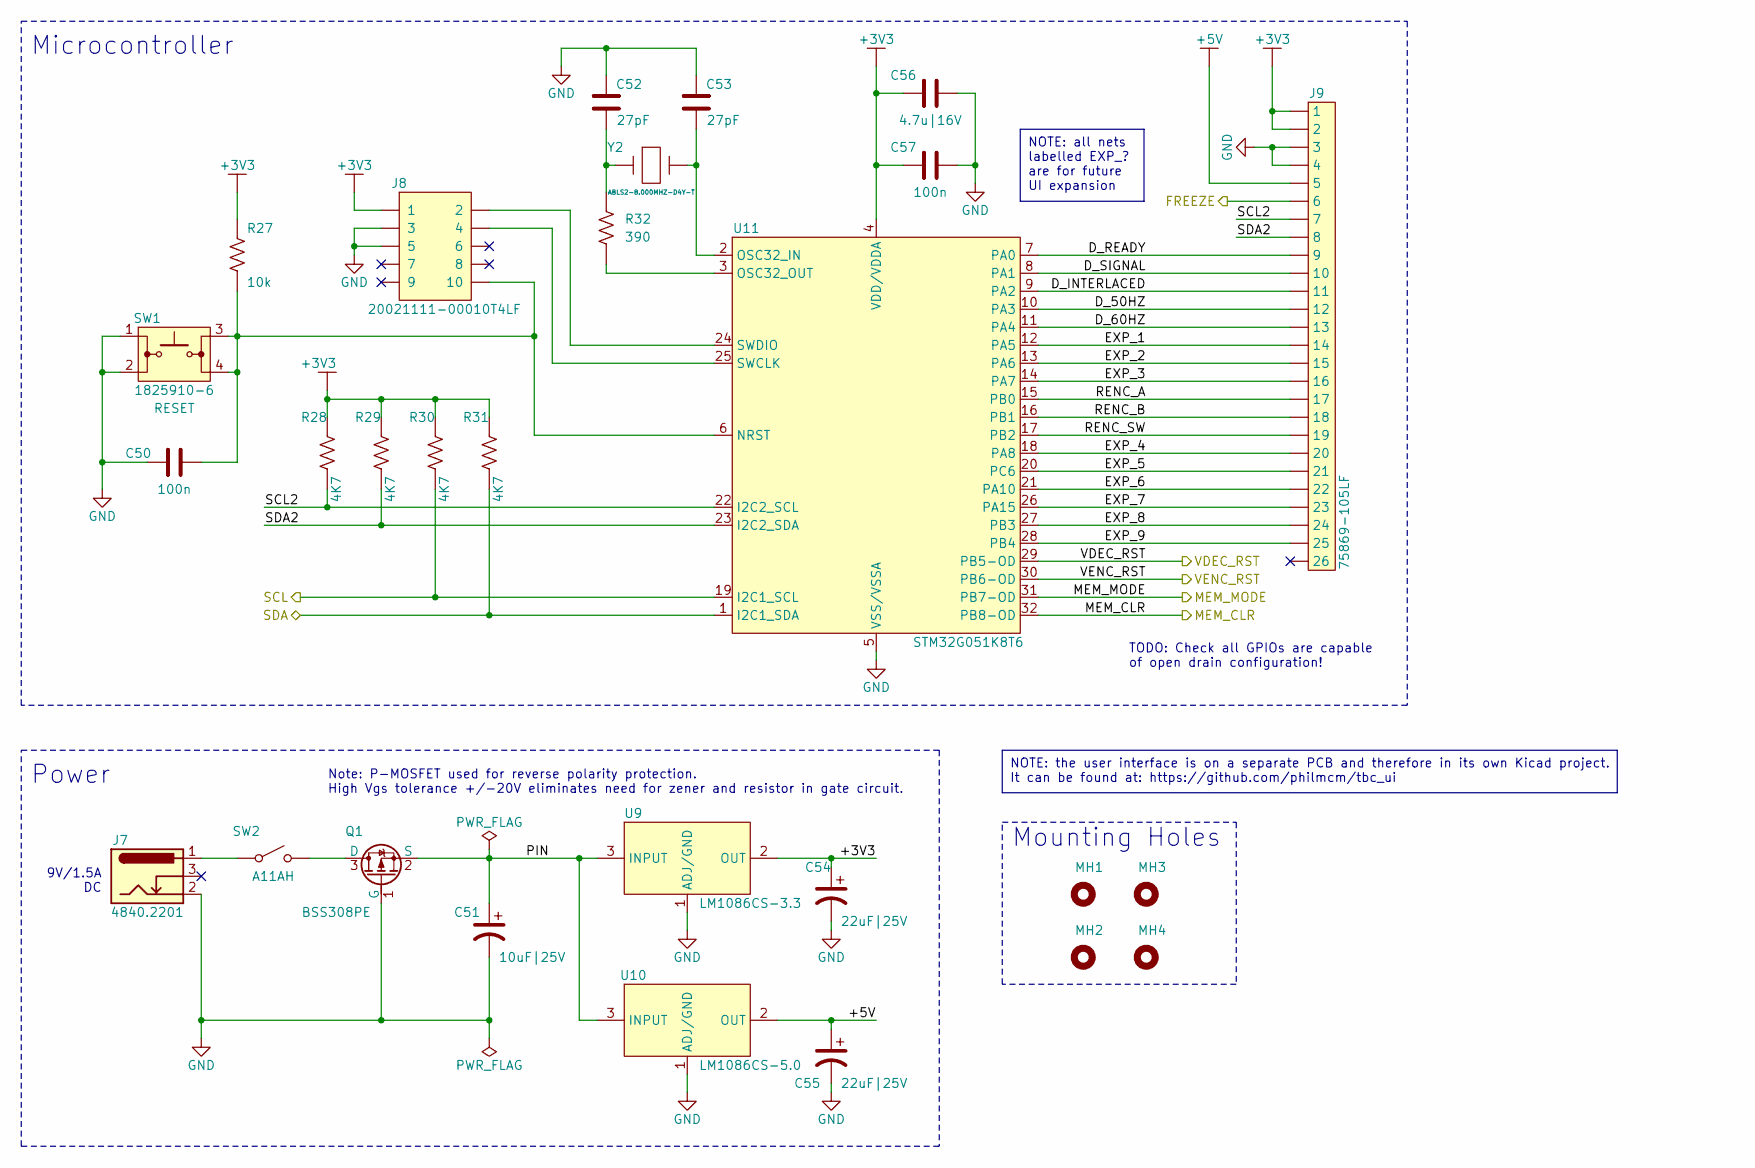
[picture p32: schematic micro_power.kicad_sch, Time Base Corrector and Video Scaler]

Parts:
C50, C57: 100n; C0603; Mouser 81-GCJ188R71H104KA2D
C51: 10uF|25V; 293D_C; Mouser 74-293D106X9025C2TE3
C52, C53: 27pF; C0603; Mouser 81-GCM1885C2A270JA6D
C54, C55: 22uF|25V; 593D_D; Mouser 74-593D226X9025D2TE3
C56: 4.7u|16V; C0603; Mouser 81-GRT188C71C475KE13
J7: 4840.2201; Mouser 693-4840.2201
J8: 20021111-00010T4LF; Digikey TC2030-IDC-ND
J9: 75869-105LF; Mouser 649-75869-105LF
MH1, MH2, MH3, MH4: MH_7.4MMNCx3.2MMD; MH_7.4MMCx3.2MMD_NON_COPPER_NPTH
Q1: BSS308PE; SOT23; Mouser 726-BSS308PEH6327XTS
R27: 10k; R0603; Mouser 603-RC0603FR-0710KL
R28, R29, R30, R31: 4K7; R0603; Mouser 603-RC0603FR-074K7L
R32: 390; R0603; Mouser 603-RC0603FR-07390RL
SW1: 1825910-6; Mouser 650-1825910-6
SW2: A11AH; Mouser 633-A11AH
U9: LM1086CS-3.3; TO-263_4.83mm; Mouser 926-LM1086CSX3.3NOPB
U10: LM1086CS-5.0; TO-263_4.83mm; Mouser 926-LM1086CS-5.0NOPB
U11: STM32G051K8T6; QFP32_7x7x1.6mm_Pitch0.8mm; Mouser 511-STM32G051K8T6
Y2: ABLS2-8.000MHZ-D4Y-T; ABLS2; Mouser 520-80-20-5PX-EM-TR

Connections:
+3V3: C54.1, C56.1, C57.1, J8.1, J9.1, J9.2, R27.2, R28.2, R29.2, R30.2, R31.2, U9.2 (OUT), U11.4 (VDD/VDDA); also elsewhere on the board
+5V: C55.1, J9.5, U10.2 (OUT); also elsewhere on the board
/Frame Memories and Freeze/FREEZE: J9.6; also elsewhere on the board
/Frame Memories and Freeze/MEM_CLR: U11.32 (PB8-OD); also elsewhere on the board
/Frame Memories and Freeze/MEM_MODE: U11.31 (PB7-OD); also elsewhere on the board
/Microcontroller, Power/D_50HZ: J9.12, U11.10 (PA3)
/Microcontroller, Power/D_60HZ: J9.13, U11.11 (PA4)
/Microcontroller, Power/D_INTERLACED: J9.11, U11.9 (PA2)
/Microcontroller, Power/D_READY: J9.9, U11.7 (PA0)
/Microcontroller, Power/D_SIGNAL: J9.10, U11.8 (PA1)
/Microcontroller, Power/EXP_1: J9.14, U11.12 (PA5)
/Microcontroller, Power/EXP_2: J9.15, U11.13 (PA6)
/Microcontroller, Power/EXP_3: J9.16, U11.14 (PA7)
/Microcontroller, Power/EXP_4: J9.20, U11.18 (PA8)
/Microcontroller, Power/EXP_5: J9.21, U11.20 (PC6)
/Microcontroller, Power/EXP_6: J9.22, U11.21 (PA10)
/Microcontroller, Power/EXP_7: J9.23, U11.26 (PA15)
/Microcontroller, Power/EXP_8: J9.24, U11.27 (PB3)
/Microcontroller, Power/EXP_9: J9.25, U11.28 (PB4)
/Microcontroller, Power/PIN: C51.1, Q1.2 (S), U9.3 (INPUT), U10.3 (INPUT)
/Microcontroller, Power/RENC_A: J9.17, U11.15 (PB0)
/Microcontroller, Power/RENC_B: J9.18, U11.16 (PB1)
/Microcontroller, Power/RENC_SW: J9.19, U11.17 (PB2)
/Microcontroller, Power/SCL: R30.1, U11.19 (I2C1_SCL); also elsewhere on the board
/Microcontroller, Power/SCL2: J9.7, R28.1, U11.22 (I2C2_SCL)
/Microcontroller, Power/SDA: R31.1, U11.1 (I2C1_SDA); also elsewhere on the board
/Microcontroller, Power/SDA2: J9.8, R29.1, U11.23 (I2C2_SDA)
/Microcontroller, Power/VDEC_RST: U11.29 (PB5-OD); also elsewhere on the board
/Microcontroller, Power/VENC_RST: U11.30 (PB6-OD); also elsewhere on the board
GND: C50.1, C51.2, C52.2, C53.2, C54.2, C55.2, C56.2, C57.2, J7.2, J8.3, J8.5, J9.3, J9.4, Q1.1 (G), SW1.1, SW1.2, U9.1 (ADJ/GND), U10.1 (ADJ/GND), U11.5 (VSS/VSSA); also elsewhere on the board
unnamed: C52.1, R32.2, Y2.1
unnamed: Q1.3 (D), SW2.3 (B)
unnamed: J7.1, SW2.1 (A)
unnamed: J8.2, U11.24 (SWDIO)
unnamed: J8.4, U11.25 (SWCLK)
unnamed: C53.1, U11.2 (OSC32_IN), Y2.2
unnamed: R32.1, U11.3 (OSC32_OUT)
unnamed: C50.2, J8.10, R27.1, SW1.3, SW1.4, U11.6 (NRST)

Notes on the sheet:
NOTE: the user interface is on a separate PCB and therefore in its own Kicad project. It can be found at: https://github.com/philmcm/tbc_ui
NOTE: all nets labelled EXP_? are for future UI expansion
Note: P-MOSFET used for reverse polarity protection. High Vgs tolerance +/-20V eliminates need for zener and resistor in gate circuit.
9V/1.5A DC
Mounting Holes
Microcontroller
TODO: Check all GPIOs are capable of open drain configuration!
Power

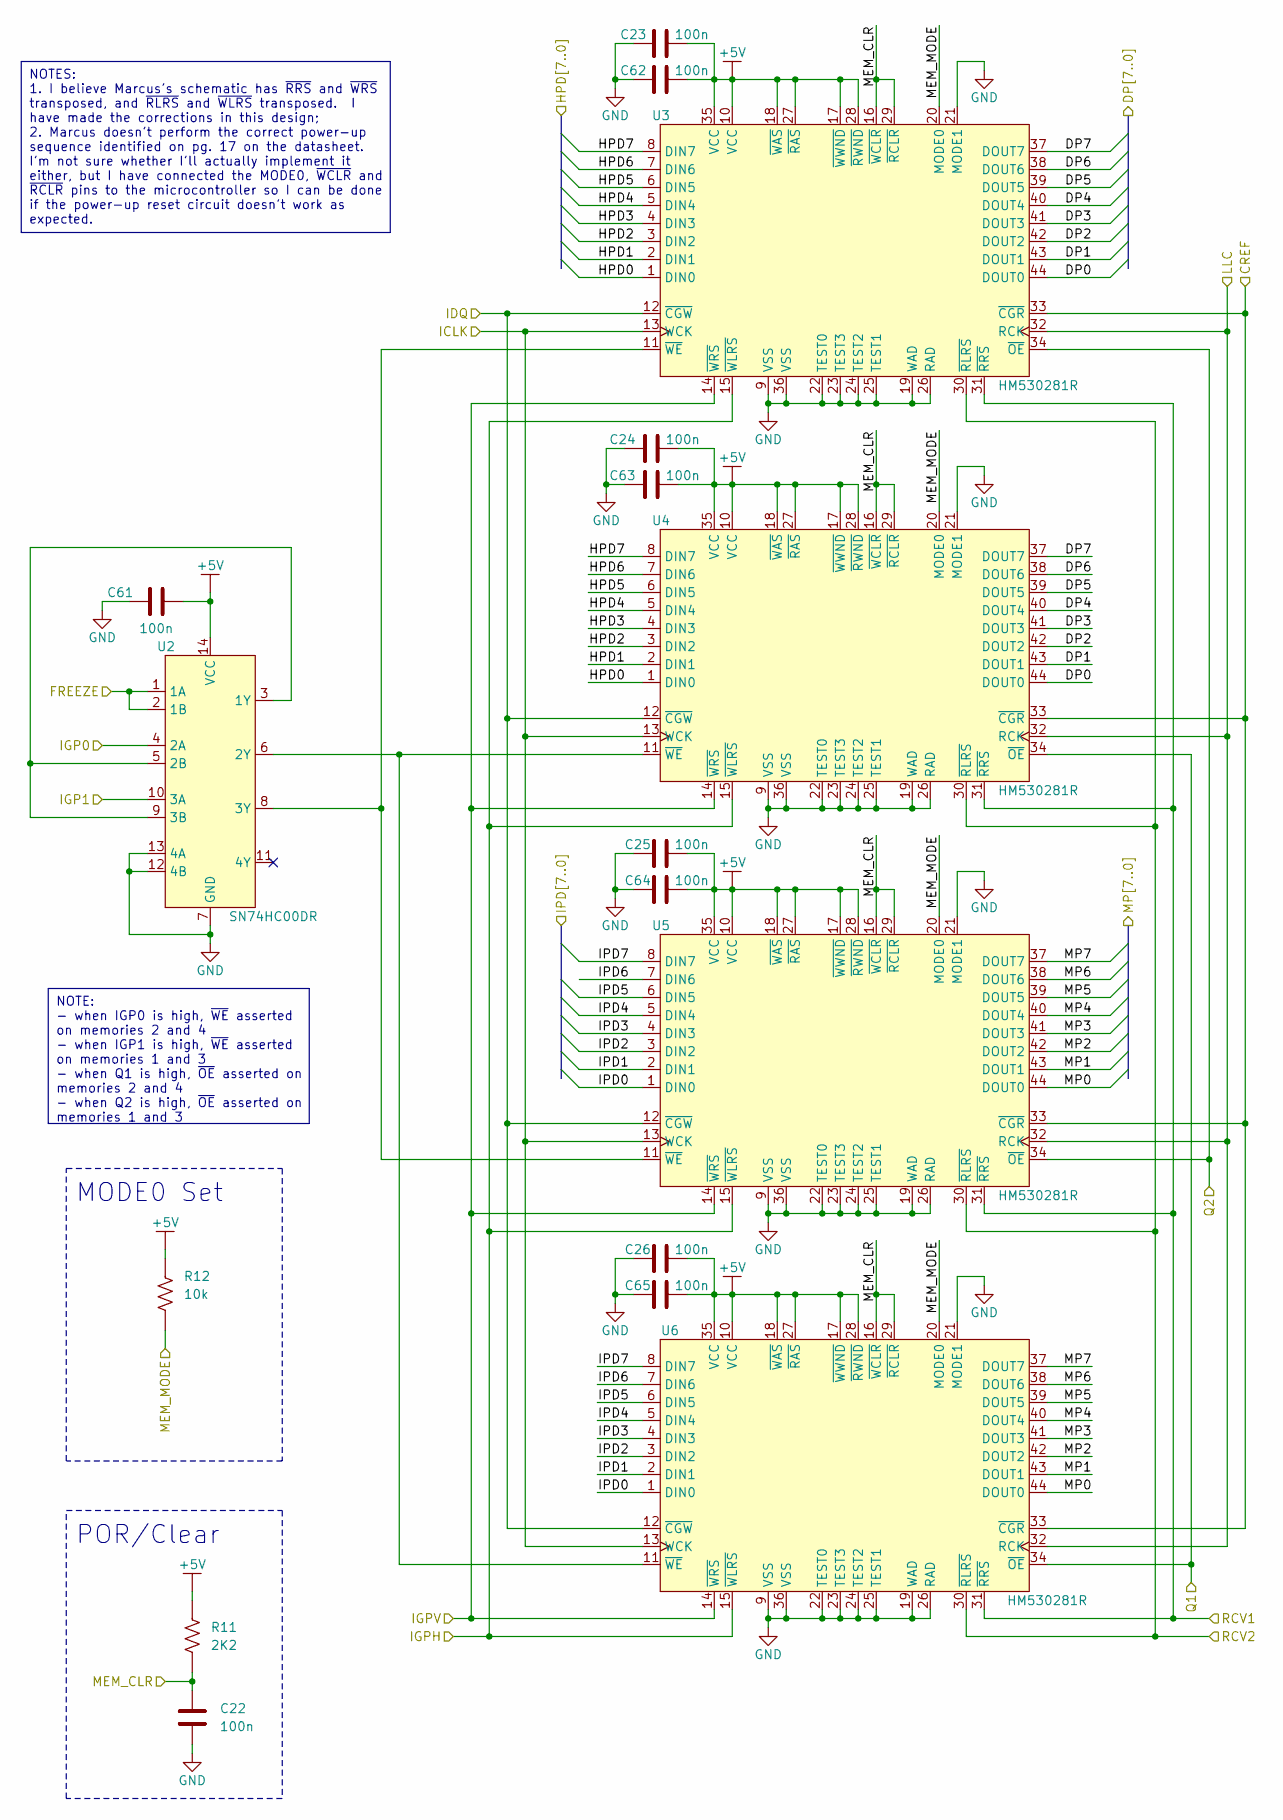
[picture p33: schematic memory.kicad_sch, Time Base Corrector and Video Scaler]

Parts:
C22, C23, C24, C25, C26, C61, C62, C63, C64, C65: 100n; C0603; Mouser 81-GCJ188R71H104KA2D
R11: 2K2; R0603; Mouser 603-RC0603FR-072K2L
R12: 10k; R0603; Mouser 603-RC0603FR-0710KL
U2: SN74HC00DR; SOIC-14; Mouser 595-SN74HC00DR
U3, U4, U5, U6: HM530281R; TTP-44DB

Connections:
+5V: C23.2, C24.2, C25.2, C26.2, C61.2, C62.2, C63.2, C64.2, C65.2, R11.2, R12.2, U2.14 (VCC), U3.10 (VCC), U3.17 (~WWND), U3.18 (~WAS), U3.27 (~RAS), U3.28 (~RWND), U3.35 (VCC), U4.10 (VCC), U4.17 (~WWND), U4.18 (~WAS), U4.27 (~RAS), U4.28 (~RWND), U4.35 (VCC), U5.10 (VCC), U5.17 (~WWND), U5.18 (~WAS), U5.27 (~RAS), U5.28 (~RWND), U5.35 (VCC), U6.10 (VCC), U6.17 (~WWND), U6.18 (~WAS), U6.27 (~RAS), U6.28 (~RWND), U6.35 (VCC); also elsewhere on the board
/Frame Memories and Freeze/CREF: U3.33 (~CGR), U4.33 (~CGR), U5.33 (~CGR), U6.33 (~CGR); also elsewhere on the board
/Frame Memories and Freeze/DP0: U3.44 (DOUT0), U4.44 (DOUT0); also elsewhere on the board
/Frame Memories and Freeze/DP1: U3.43 (DOUT1), U4.43 (DOUT1); also elsewhere on the board
/Frame Memories and Freeze/DP2: U3.42 (DOUT2), U4.42 (DOUT2); also elsewhere on the board
/Frame Memories and Freeze/DP3: U3.41 (DOUT3), U4.41 (DOUT3); also elsewhere on the board
/Frame Memories and Freeze/DP4: U3.40 (DOUT4), U4.40 (DOUT4); also elsewhere on the board
/Frame Memories and Freeze/DP5: U3.39 (DOUT5), U4.39 (DOUT5); also elsewhere on the board
/Frame Memories and Freeze/DP6: U3.38 (DOUT6), U4.38 (DOUT6); also elsewhere on the board
/Frame Memories and Freeze/DP7: U3.37 (DOUT7), U4.37 (DOUT7); also elsewhere on the board
/Frame Memories and Freeze/FREEZE: U2.1 (1A), U2.2 (1B); also elsewhere on the board
/Frame Memories and Freeze/HPD0: U3.1 (DIN0), U4.1 (DIN0); also elsewhere on the board
/Frame Memories and Freeze/HPD1: U3.2 (DIN1), U4.2 (DIN1); also elsewhere on the board
/Frame Memories and Freeze/HPD2: U3.3 (DIN2), U4.3 (DIN2); also elsewhere on the board
/Frame Memories and Freeze/HPD3: U3.4 (DIN3), U4.4 (DIN3); also elsewhere on the board
/Frame Memories and Freeze/HPD4: U3.5 (DIN4), U4.5 (DIN4); also elsewhere on the board
/Frame Memories and Freeze/HPD5: U3.6 (DIN5), U4.6 (DIN5); also elsewhere on the board
/Frame Memories and Freeze/HPD6: U3.7 (DIN6), U4.7 (DIN6); also elsewhere on the board
/Frame Memories and Freeze/HPD7: U3.8 (DIN7), U4.8 (DIN7); also elsewhere on the board
/Frame Memories and Freeze/ICLK: U3.13 (WCK), U4.13 (WCK), U5.13 (WCK), U6.13 (WCK); also elsewhere on the board
/Frame Memories and Freeze/IDQ: U3.12 (~CGW), U4.12 (~CGW), U5.12 (~CGW), U6.12 (~CGW); also elsewhere on the board
/Frame Memories and Freeze/IGP0: U2.4 (2A); also elsewhere on the board
/Frame Memories and Freeze/IGP1: U2.10 (3A); also elsewhere on the board
/Frame Memories and Freeze/IGPH: U3.15 (~WLRS), U4.15 (~WLRS), U5.15 (~WLRS), U6.15 (~WLRS); also elsewhere on the board
/Frame Memories and Freeze/IGPV: U3.14 (~WRS), U4.14 (~WRS), U5.14 (~WRS), U6.14 (~WRS); also elsewhere on the board
/Frame Memories and Freeze/IPD0: U5.1 (DIN0), U6.1 (DIN0); also elsewhere on the board
/Frame Memories and Freeze/IPD1: U5.2 (DIN1), U6.2 (DIN1); also elsewhere on the board
/Frame Memories and Freeze/IPD2: U5.3 (DIN2), U6.3 (DIN2); also elsewhere on the board
/Frame Memories and Freeze/IPD3: U5.4 (DIN3), U6.4 (DIN3); also elsewhere on the board
/Frame Memories and Freeze/IPD4: U5.5 (DIN4), U6.5 (DIN4); also elsewhere on the board
/Frame Memories and Freeze/IPD5: U5.6 (DIN5), U6.6 (DIN5); also elsewhere on the board
/Frame Memories and Freeze/IPD6: U5.7 (DIN6), U6.7 (DIN6); also elsewhere on the board
/Frame Memories and Freeze/IPD7: U5.8 (DIN7), U6.8 (DIN7); also elsewhere on the board
/Frame Memories and Freeze/LLC: U3.32 (RCK), U4.32 (RCK), U5.32 (RCK), U6.32 (RCK); also elsewhere on the board
/Frame Memories and Freeze/MEM_CLR: C22.2, R11.1, U3.16 (~WCLR), U3.29 (~RCLR), U4.16 (~WCLR), U4.29 (~RCLR), U5.16 (~WCLR), U5.29 (~RCLR), U6.16 (~WCLR), U6.29 (~RCLR); also elsewhere on the board
/Frame Memories and Freeze/MEM_MODE: R12.1, U3.20 (MODE0), U4.20 (MODE0), U5.20 (MODE0), U6.20 (MODE0); also elsewhere on the board
/Frame Memories and Freeze/MP0: U5.44 (DOUT0), U6.44 (DOUT0); also elsewhere on the board
/Frame Memories and Freeze/MP1: U5.43 (DOUT1), U6.43 (DOUT1); also elsewhere on the board
/Frame Memories and Freeze/MP2: U5.42 (DOUT2), U6.42 (DOUT2); also elsewhere on the board
/Frame Memories and Freeze/MP3: U5.41 (DOUT3), U6.41 (DOUT3); also elsewhere on the board
/Frame Memories and Freeze/MP4: U5.40 (DOUT4), U6.40 (DOUT4); also elsewhere on the board
/Frame Memories and Freeze/MP5: U5.39 (DOUT5), U6.39 (DOUT5); also elsewhere on the board
/Frame Memories and Freeze/MP6: U5.38 (DOUT6), U6.38 (DOUT6); also elsewhere on the board
/Frame Memories and Freeze/MP7: U5.37 (DOUT7), U6.37 (DOUT7); also elsewhere on the board
/Frame Memories and Freeze/Q1: U4.34 (~OE), U6.34 (~OE); also elsewhere on the board
/Frame Memories and Freeze/Q2: U3.34 (~OE), U5.34 (~OE); also elsewhere on the board
/Frame Memories and Freeze/RCV1: U3.31 (~RRS), U4.31 (~RRS), U5.31 (~RRS), U6.31 (~RRS); also elsewhere on the board
/Frame Memories and Freeze/RCV2: U3.30 (~RLRS), U4.30 (~RLRS), U5.30 (~RLRS), U6.30 (~RLRS); also elsewhere on the board
GND: C22.1, C23.1, C24.1, C25.1, C26.1, C61.1, C62.1, C63.1, C64.1, C65.1, U2.7 (GND), U2.12 (4B), U2.13 (4A), U3.9 (VSS), U3.19 (WAD), U3.21 (MODE1), U3.22 (TEST0), U3.23 (TEST3), U3.24 (TEST2), U3.25 (TEST1), U3.26 (RAD), U3.36 (VSS), U4.9 (VSS), U4.19 (WAD), U4.21 (MODE1), U4.22 (TEST0), U4.23 (TEST3), U4.24 (TEST2), U4.25 (TEST1), U4.26 (RAD), U4.36 (VSS), U5.9 (VSS), U5.19 (WAD), U5.21 (MODE1), U5.22 (TEST0), U5.23 (TEST3), U5.24 (TEST2), U5.25 (TEST1), U5.26 (RAD), U5.36 (VSS), U6.9 (VSS), U6.19 (WAD), U6.21 (MODE1), U6.22 (TEST0), U6.23 (TEST3), U6.24 (TEST2), U6.25 (TEST1), U6.26 (RAD), U6.36 (VSS); also elsewhere on the board
unnamed: U2.3 (1Y), U2.5 (2B), U2.9 (3B)
unnamed: U2.6 (2Y), U4.11 (~WE), U6.11 (~WE)
unnamed: U2.8 (3Y), U3.11 (~WE), U5.11 (~WE)

Notes on the sheet:
NOTE: - when IGP0 is high, ~{WE} asserted on memories 2 and 4 - when IGP1 is high, ~{WE} asserted on memories 1 and 3 - when Q1 is high, ~{OE} asserted on memories 2 and 4 - when Q2 is high, ~{OE} asserted on memories 1 and 3
NOTES: 1. I believe Marcus's schematic has ~{RRS} and ~{WRS} transposed, and ~{RLRS} and ~{WLRS} transposed. I have made the corrections in this design; 2. Marcus doesn't perform the correct power-up sequence identified on pg. 17 on the datasheet. I'm not sure whether I'll actually implement it eit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
MODE0 Set
POR/Clear
