philmcm/tbc/tbc.kicad_pcb

## KiCad design tbc.kicad_pcb (continued)

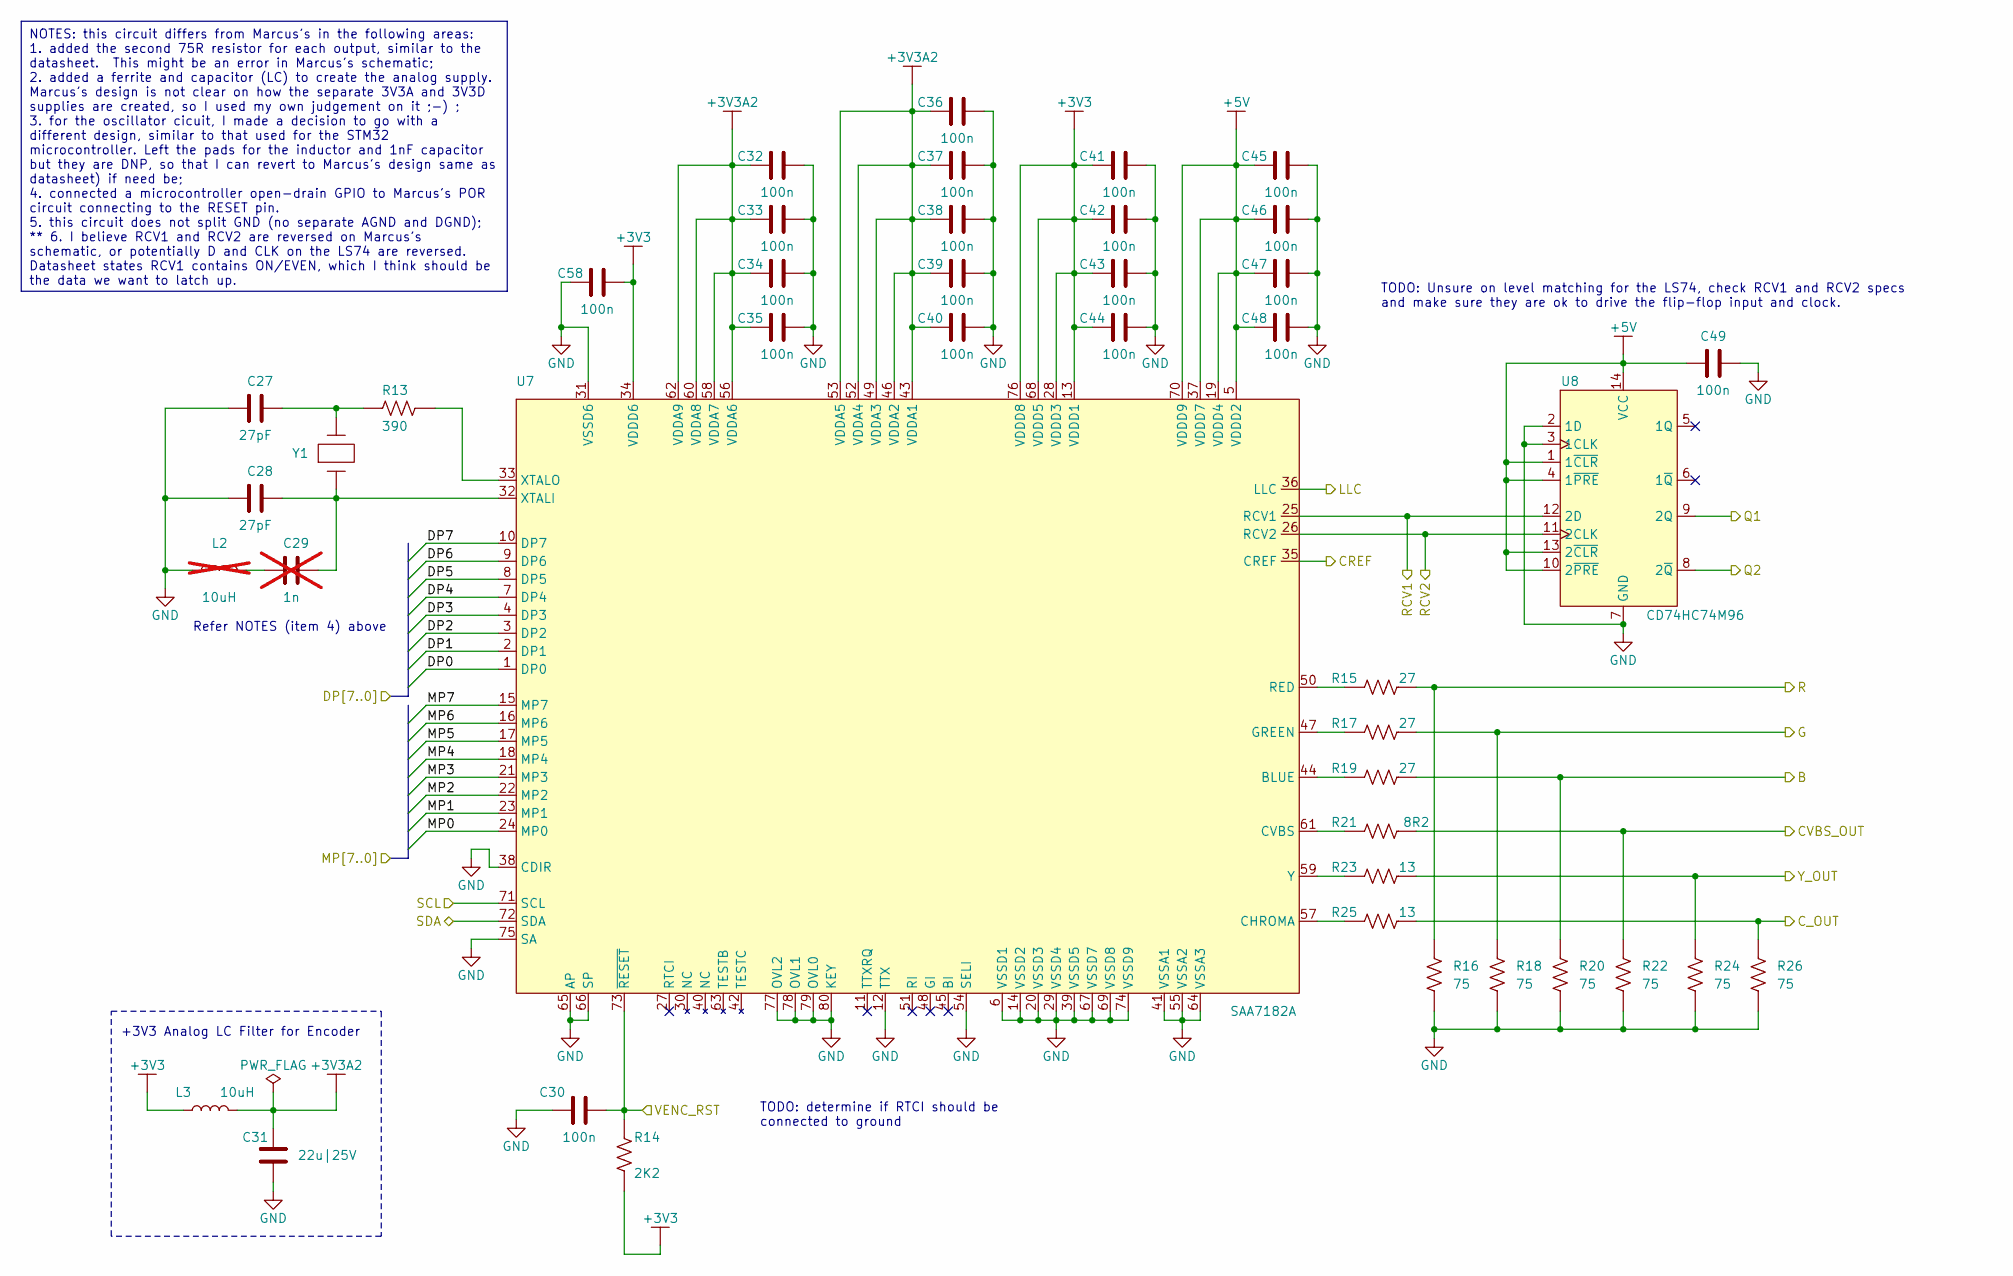
[picture p34: schematic encoder.kicad_sch, Time Base Corrector and Video Scaler]

Parts:
C27, C28: 27pF; C0603; Mouser 81-GCM1885C2A270JA6D
C29: 1n; C0603; Mouser 81-GCM1885C2A102FA6D; not fitted
C30, C32, C33, C34, C35, C36, C37, C38, C39, C40, C41, C42, C43, C44, C45, C46, C47, C48, C49, C58: 100n; C0603; Mouser 81-GCJ188R71H104KA2D
C31: 22u|25V; GRM32; Mouser 81-GRM32ER71E226KE5L
L2: 10uH; L0805; Mouser 81-LQM21DH100M70L; not fitted
L3: 10uH; DFE201610E; Mouser 81-DFE201610E-100MP2
R13: 390; R0603; Mouser 603-RC0603FR-07390RL
R14: 2K2; R0603; Mouser 603-RC0603FR-072K2L
R15, R17, R19: 27; R0603; Mouser 603-RC0603FR-0727RL
R16, R18, R20, R22, R24, R26: 75; R0603; Mouser 603-RC0603FR-0775RL
R21: 8R2; R0603; Mouser 603-RC0603FR-078R2L
R23, R25: 13; R0603; Mouser 603-RC0603FR-0713RL
U7: SAA7182A; QFP80_14x20x2.8mm_Pitch0.8mm
U8: CD74HC74M96; SOIC-14; Mouser 595-CD74HC74M96
Y1: ABLS-27.000MHZ-B2F-T; ABLS; Mouser 815-ABLS-27-B2

Connections:
+3V3: C41.1, C42.1, C43.1, C44.1, C58.2, L3.1, R14.1, U7.13 (VDDD1), U7.28 (VDDD3), U7.34 (VDDD6), U7.68 (VDDD5), U7.76 (VDDD8); also elsewhere on the board
+3V3A2: C31.1, C32.1, C33.1, C34.1, C35.1, C36.1, C37.1, C38.1, C39.1, C40.1, L3.2, U7.43 (VDDA1), U7.46 (VDDA2), U7.49 (VDDA3), U7.52 (VDDA4), U7.53 (VDDA5), U7.56 (VDDA6), U7.58 (VDDA7), U7.60 (VDDA8), U7.62 (VDDA9)
+5V: C45.1, C46.1, C47.1, C48.1, C49.1, U7.5 (VDDD2), U7.19 (VDDD4), U7.37 (VDDD7), U7.70 (VDDD9), U8.1 (1~CLR), U8.4 (1~PRE), U8.10 (2~PRE), U8.13 (2~CLR), U8.14 (VCC); also elsewhere on the board
/Frame Memories and Freeze/CREF: U7.35 (CREF); also elsewhere on the board
/Frame Memories and Freeze/DP0: U7.1 (DP0); also elsewhere on the board
/Frame Memories and Freeze/DP1: U7.2 (DP1); also elsewhere on the board
/Frame Memories and Freeze/DP2: U7.3 (DP2); also elsewhere on the board
/Frame Memories and Freeze/DP3: U7.4 (DP3); also elsewhere on the board
/Frame Memories and Freeze/DP4: U7.7 (DP4); also elsewhere on the board
/Frame Memories and Freeze/DP5: U7.8 (DP5); also elsewhere on the board
/Frame Memories and Freeze/DP6: U7.9 (DP6); also elsewhere on the board
/Frame Memories and Freeze/DP7: U7.10 (DP7); also elsewhere on the board
/Frame Memories and Freeze/LLC: U7.36 (LLC); also elsewhere on the board
/Frame Memories and Freeze/MP0: U7.24 (MP0); also elsewhere on the board
/Frame Memories and Freeze/MP1: U7.23 (MP1); also elsewhere on the board
/Frame Memories and Freeze/MP2: U7.22 (MP2); also elsewhere on the board
/Frame Memories and Freeze/MP3: U7.21 (MP3); also elsewhere on the board
/Frame Memories and Freeze/MP4: U7.18 (MP4); also elsewhere on the board
/Frame Memories and Freeze/MP5: U7.17 (MP5); also elsewhere on the board
/Frame Memories and Freeze/MP6: U7.16 (MP6); also elsewhere on the board
/Frame Memories and Freeze/MP7: U7.15 (MP7); also elsewhere on the board
/Frame Memories and Freeze/Q1: U8.9 (2Q); also elsewhere on the board
/Frame Memories and Freeze/Q2: U8.8 (2~Q); also elsewhere on the board
/Frame Memories and Freeze/RCV1: U7.25 (RCV1), U8.12 (2D); also elsewhere on the board
/Frame Memories and Freeze/RCV2: U7.26 (RCV2), U8.11 (2CLK); also elsewhere on the board
/Microcontroller, Power/SCL: U7.71 (SCL); also elsewhere on the board
/Microcontroller, Power/SDA: U7.72 (SDA); also elsewhere on the board
/Microcontroller, Power/VENC_RST: C30.2, R14.2, U7.73 (~RESET); also elsewhere on the board
/Video Encoder/B: R19.2, R20.2; also elsewhere on the board
/Video Encoder/CVBS_OUT: R21.2, R22.2; also elsewhere on the board
/Video Encoder/C_OUT: R25.2, R26.2; also elsewhere on the board
/Video Encoder/G: R17.2, R18.2; also elsewhere on the board
/Video Encoder/R: R15.2, R16.2; also elsewhere on the board
/Video Encoder/Y_OUT: R23.2, R24.2; also elsewhere on the board
GND: C27.2, C28.2, C30.1, C31.2, C32.2, C33.2, C34.2, C35.2, C36.2, C37.2, C38.2, C39.2, C40.2, C41.2, C42.2, C43.2, C44.2, C45.2, C46.2, C47.2, C48.2, C49.2, C58.1, L2.1, R16.1, R18.1, R20.1, R22.1, R24.1, R26.1, U7.6 (VSSD1), U7.12 (TTX), U7.14 (VSSD2), U7.20 (VSSD3), U7.29 (VSSD4), U7.31 (VSSD6), U7.38 (CDIR), U7.39 (VSSD5), U7.41 (VSSA1), U7.54 (SELI), U7.55 (VSSA2), U7.64 (VSSA3), U7.65 (AP), U7.66 (SP), U7.67 (VSSD7), U7.69 (VSSD8), U7.74 (VSSD9), U7.75 (SA), U7.77 (OVL2), U7.78 (OVL1), U7.79 (OVL0), U7.80 (KEY), U8.2 (1D), U8.3 (1CLK), U8.7 (GND); also elsewhere on the board
unnamed: C27.1, R13.2, Y1.2
unnamed: C29.2, L2.2
unnamed: R19.1, U7.44 (BLUE)
unnamed: R25.1, U7.57 (CHROMA)
unnamed: R21.1, U7.61 (CVBS)
unnamed: R17.1, U7.47 (GREEN)
unnamed: R15.1, U7.50 (RED)
unnamed: C28.1, C29.1, U7.32 (XTALI), Y1.1
unnamed: R13.1, U7.33 (XTALO)
unnamed: R23.1, U7.59 (Y)

Notes on the sheet:
NOTES: this circuit differs from Marcus's in the following areas: 1. added the second 75R resistor for each output, similar to the datasheet. This might be an error in Marcus's schematic; 2. added a ferrite and capacitor (LC) to create the analog supply. Marcus's design is not clear on how the sepa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
TODO: Unsure on level matching for the LS74, check RCV1 and RCV2 specs and make sure they are ok to drive the flip-flop input and clock.
+3V3 Analog LC Filter for Encoder
TODO: determine if RTCI should be connected to ground
Refer NOTES (item 4) above

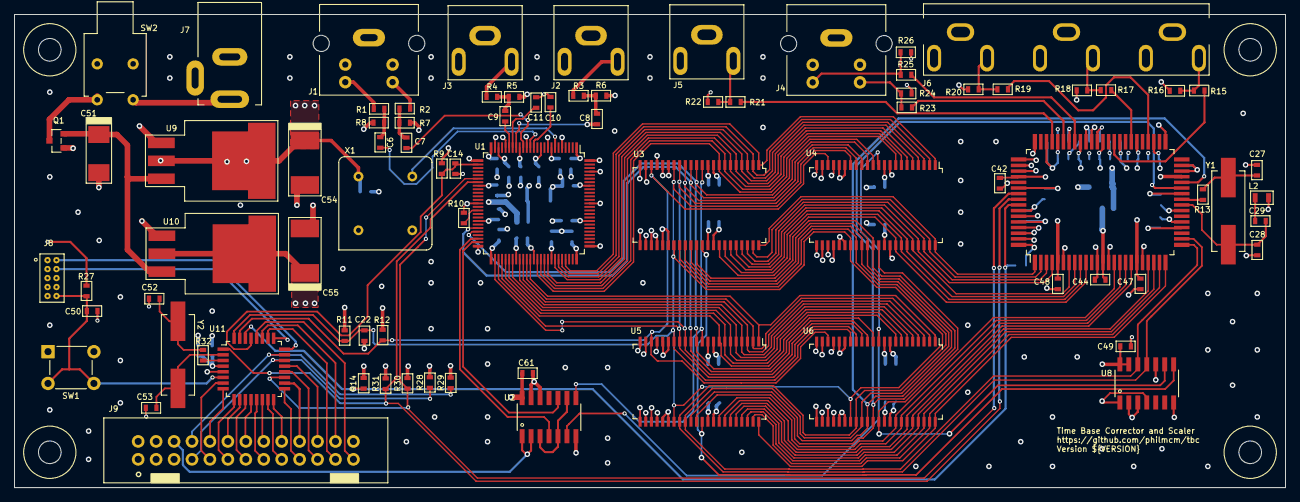
[picture p35: board tbc.kicad_pcb from above]

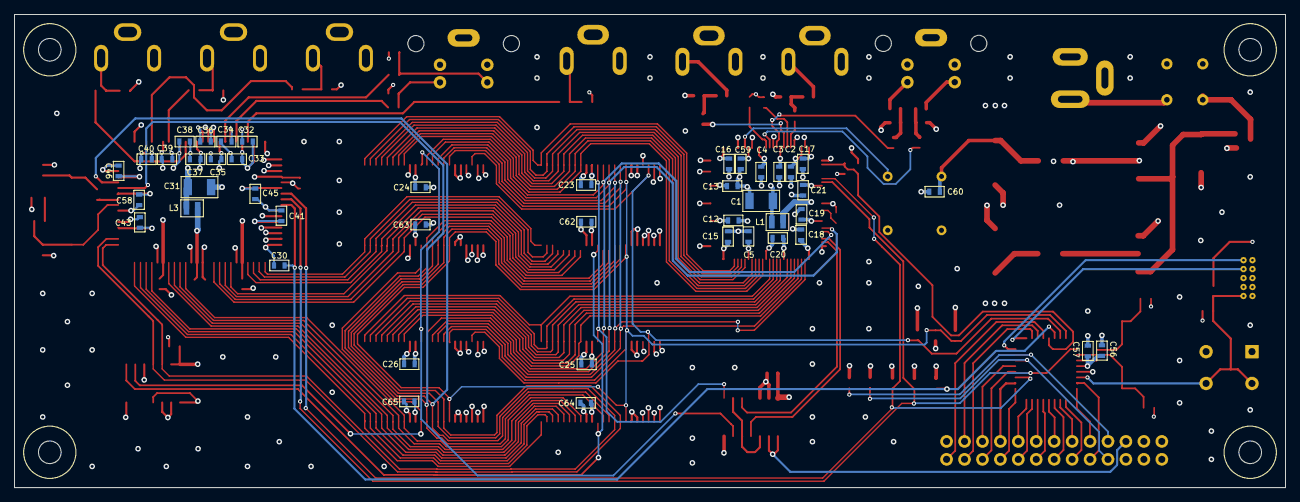
[picture p36: board tbc.kicad_pcb from below]

Board: 4 copper layers, 180.0 x 67.0 mm, 130 parts (44 on the bottom side), 119 nets.
