philmcm/tbc/(commit log)

2023-11-30 Committed footprints, updated .gitignore
2024-01-15 initial work on schematic symbol creation
    [micro_ui.kicad_sch, tbc.kicad_sch, video_proc.kicad_sch]
2024-01-15 added symbols for i2c res and decoupling cap
    [micro_ui.kicad_sch]
2024-01-15 changed hierarchy, added symbols
    [decoder.kicad_sch, memory.kicad_sch, micro_ui.kicad_sch, tbc.kicad_sch, video_proc.kicad_sch]
2024-01-16 continuing schematic capture, renamed sheets
    [decoder.kicad_sch, encoder.kicad_sch, memory.kicad_sch, tbc.kicad_sch, video_proc.kicad_sch]
2024-01-16 added decoder symbol
    [decoder.kicad_sch, encoder.kicad_sch, memory.kicad_sch, tbc.kicad_sch]
2024-01-16 added buses, title block info
    [decoder.kicad_sch, encoder.kicad_sch, memory.kicad_sch, micro_ui.kicad_sch, tbc.kicad_sch]
2024-01-16 added frame memory symbol and updated schematic
    [decoder.kicad_sch, encoder.kicad_sch, memory.kicad_sch, micro_ui.kicad_sch]
2024-01-19 continued on schematic, added power sheet
    [decoder.kicad_sch, encoder.kicad_sch, memory.kicad_sch, micro_ui.kicad_sch, power.kicad_sch, tbc.kicad_sch]
2024-01-22 updates to power, ferrites etc
    [decoder.kicad_sch, encoder.kicad_sch, memory.kicad_sch, micro_ui.kicad_sch, power.kicad_sch]
2024-01-24 added encoder to schematic
    [memory.kicad_sch, micro_ui.kicad_sch, power.kicad_sch]
2024-01-25 moved UI (2nd board) to its own project, other updates
    [micro_power.kicad_sch, micro_ui.kicad_sch, power.kicad_sch, tbc.kicad_sch]
2024-01-25 renamed micro_ui to micro_power
    [tbc.kicad_sch]
2024-01-25 major progress with memory interfacing
    [encoder.kicad_sch, memory.kicad_sch, micro_power.kicad_sch, tbc.kicad_sch]
2024-01-25 minor changes to schematic layout
    [encoder.kicad_sch, memory.kicad_sch, micro_power.kicad_sch]
2024-01-26 added connectors and crystal, osc
    [decoder.kicad_sch, encoder.kicad_sch, memory.kicad_sch, micro_power.kicad_sch, tbc.kicad_sch]
2024-01-26 completed and annotated schematic, passed ERC
    [decoder.kicad_sch, encoder.kicad_sch, memory.kicad_sch, micro_power.kicad_sch, tbc.kicad_sch]
2024-01-26 connected shunt pins on switchcraft sockets correctly
    [tbc.kicad_sch]
2024-01-27 added notes, schematic cleanup
    [LQFP100_05.step, decoder.kicad_sch, encoder.kicad_sch, memory.kicad_sch, micro_power.kicad_sch, tbc.kicad_pcb, tbc.kicad_sch]
2024-01-27 minor cleanup, addition of notes
    [decoder.kicad_sch, encoder.kicad_sch, memory.kicad_sch, micro_power.kicad_sch, tbc.kicad_sch]
2024-02-10 added footprints for large ICs
    [LQFP32.STEP, QFP80_080.step, TSOP-44_II.step, decoder.kicad_sch, encoder.kicad_sch, memory.kicad_sch, micro_power.kicad_sch, tbc.kicad_pcb]
2024-02-10 resistor footprint added
    [R0603.step, decoder.kicad_sch, encoder.kicad_sch, memory.kicad_sch, micro_power.kicad_sch, tbc.kicad_pcb]
2024-02-11 added connector footprints
    [4840.2201-04.STEP, A11AH-GA.stp, PJRAN3X1U03X--3DModel-STEP-56544.STEP, c-5749181-1-a-3d.stp, decoder.kicad_sch, micro_power.kicad_sch, pjran1x1_Series.STEP, tbc.kicad_pcb]
2024-02-11 mosfet and tantalum footprints
    [C-CASE.stp, CircuitWorks-SOT-23.step, D-CASE.stp, micro_power.kicad_sch, tbc.kicad_pcb]
2024-02-11 completed power footprints
    [KTT0003B.stp, micro_power.kicad_sch, tbc.kicad_pcb]
2024-02-12 footprints and 3d models for caps, connectors
    [20021111-00010T4LF.STEP, ACHL.STEP, C0603x0.8mm.STEP, FSM4JLH(1825910-5).step, decoder.kicad_sch, encoder.kicad_sch, memory.kicad_sch, micro_power.kicad_sch]
2024-02-14 initial work on layout
    [D0014A.stp, encoder.kicad_sch, memory.kicad_sch, tbc.kicad_pcb]
2024-02-15 converted to 4-layer pcb
    [tbc.kicad_pcb]
2024-02-18 added connector and diode footprint, more layout
    [1N4148WS.stp, 75869-105LF--3DModel-STEP-56544.STEP, micro_power.kicad_sch, tbc.kicad_pcb]
2024-02-18 added footprints for crystals and updated layout
    [ABLS.STEP, ABLS2.STEP, encoder.kicad_sch, micro_power.kicad_sch, tbc.kicad_pcb]
2024-02-19 3V3A component footprints + layout work
    [DFE201610E-100M%3DP2.STEP, GRM32ER71E226KE15L.STEP, decoder.kicad_sch, encoder.kicad_sch, tbc.kicad_pcb]
2024-02-19 layout LHS
    [encoder.kicad_sch, tbc.kicad_pcb]
2024-02-19 extra bypass cap for memories + more layout
    [memory.kicad_sch, tbc.kicad_pcb]
2024-02-20 layout complete and passed DRC
    [LQM21DH100M70L.STEP, decoder.kicad_sch, encoder.kicad_sch, tbc.kicad_pcb]
2024-02-22 add PEC11R footprint, minor enhancements to layout
    [PEC11R-4220F-S0024.stp, micro_power.kicad_sch, tbc.kicad_pcb]
2024-02-22 moved UI footprints to separate library
    [1N4148WS.stp, PEC11R-4220F-S0024.stp]
2024-02-23 update to Kicad 8.0, add gerbers
    [decoder.kicad_sch, encoder.kicad_sch, memory.kicad_sch, micro_power.kicad_sch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]
2024-07-08 added copper pours to layers
    [tbc-B_Cu.gbl, tbc-B_Mask.gbs, tbc-B_Silkscreen.gbo, tbc-Edge_Cuts.gm1, tbc-F_Cu.gtl, tbc-F_Mask.gts, tbc-F_Silkscreen.gto, tbc-NPTH.drl]
2025-01-18 updates from library, performed ERC/DRC, update Kicad 8.0.8
    [decoder.kicad_sch, encoder.kicad_sch, memory.kicad_sch, micro_power.kicad_sch, tbc.kicad_pcb, tbc.kicad_sch]
