philmcm/tbc/(notices)

Notices in the files:
tbc.kicad_sch:
Enhancements © 2024 Phil McMillan
Original TBC circuit design © 2001 Marcus Gunnarsson (refer links on left)
3dmodels/A11AH-GA.stp:
author */ ('License CC BY-ND 4.0'),
